spudger/marathon/schematics/README.md

# Schematics

Exports of the Marathon schematic, for viewing without KiCad.

**Status:** Phase 3, mostly complete, with ERC clean. The source is [`../pcb/marathon.kicad_sch`](../pcb/marathon.kicad_sch).

Will contain `marathon.pdf`, added once the sheet layout has been cleaned up for readability.
