spudger/marathon/case/renders/angle-back.png

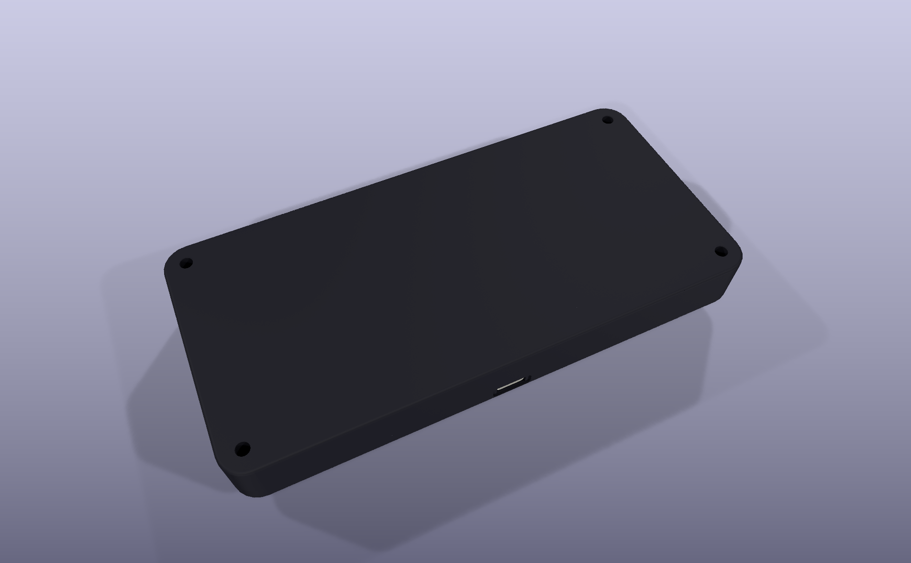
case/renders/angle-back.png
