spudger/marathon/case/renders/exploded.png

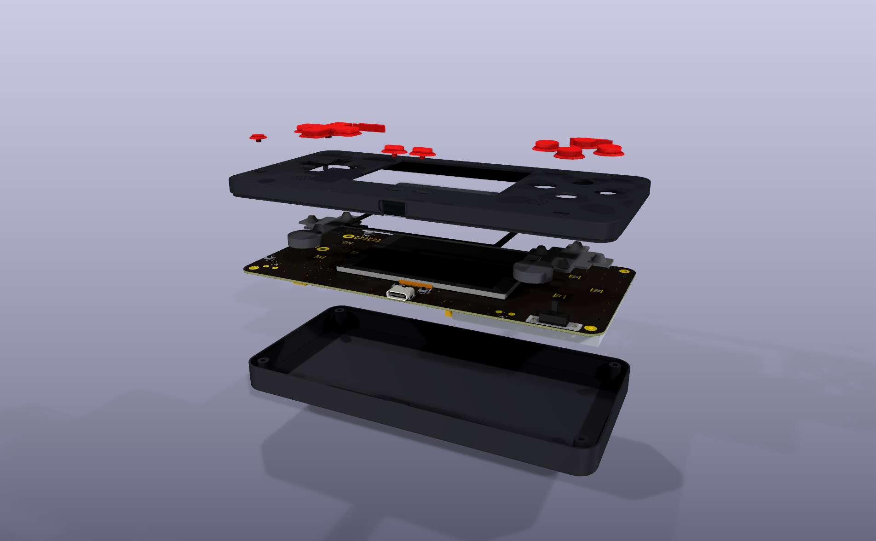
case/renders/exploded.png
