spudger/marathon/case/renders/section.png

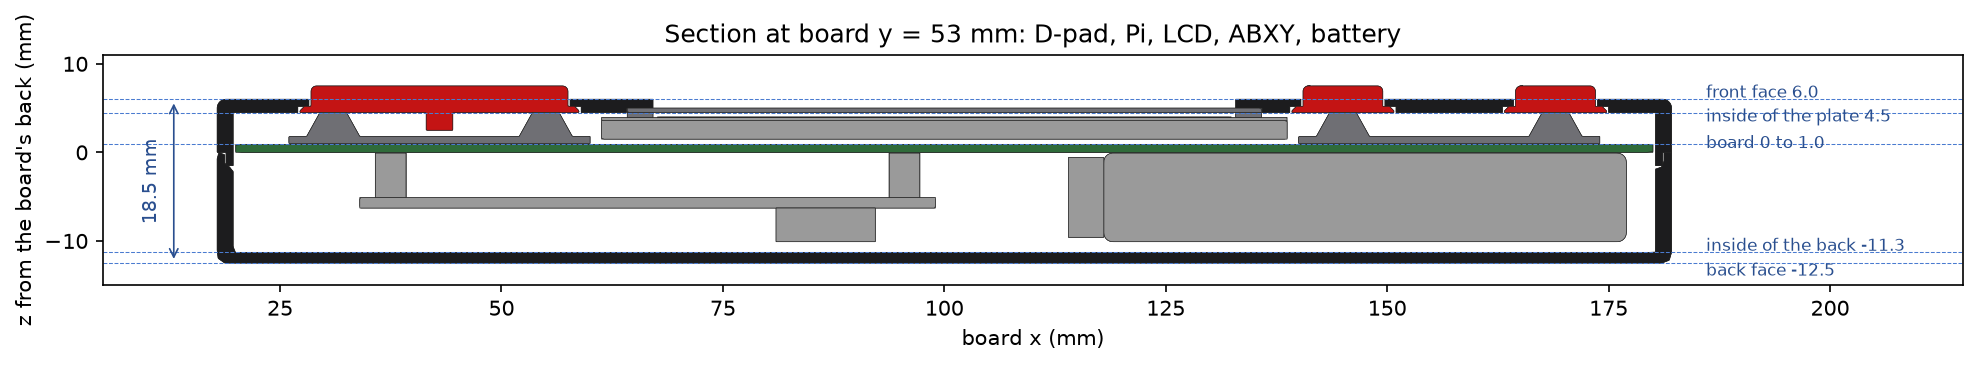
case/renders/section.png
