spudger/marathon/case/renders/social-preview.png

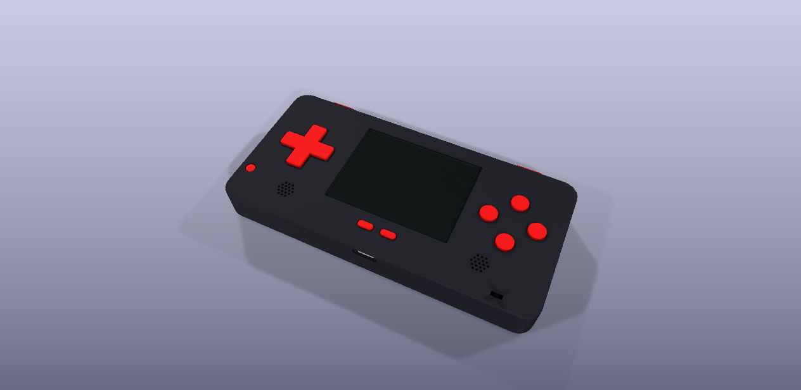
case/renders/social-preview.png
