spudger/marathon/pcb/renders/bottom.png

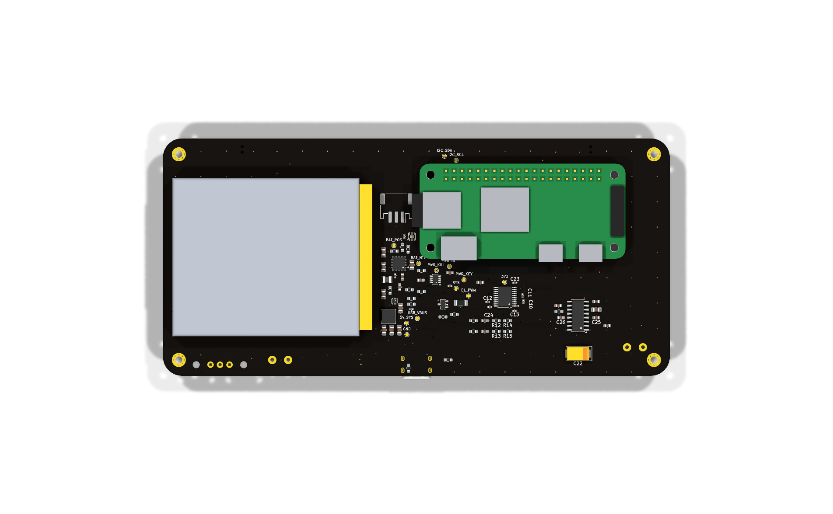
pcb/renders/bottom.png
