spudger/marathon/pcb/renders/top.png

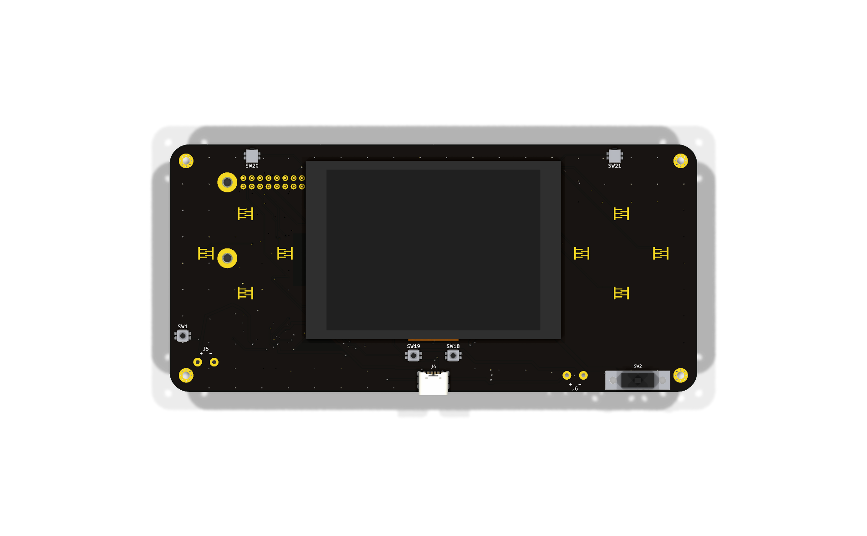
pcb/renders/top.png
