spudger/marathon/bom/README.md

# Marathon - Bill of Materials

Prototype work also uses a standard breadboard, jumper wires, and tactile push buttons for GPIO testing. These are commodity items and are not listed as line items below.

---

## 1. Compute

| Component | Spec | Est. Cost | Notes |
|---|---|---|---|
| Raspberry Pi Zero 2 W | ARM Cortex-A53, WiFi/BT | ~$15 | No-headers variant recommended for the final PCB. The Pi mounts on the back of the board on 5 mm M2.5 nylon standoffs, joined by a 2x20 strip of long-tail header pins soldered through both boards. The WH (with headers) is fine for breadboard prototyping, but its header would have to come off first. |

## 2. Power

| Component | Spec | Est. Cost | Notes |
|---|---|---|---|
| IP5306 breakout board (prototype) | 5V 2A boost + LiPo charger + load sharing | $10 (10-pack) | Outputs 5.1V. No USB port on this board variant; USB-C cable soldered directly to VIN/GND. Auto-shuts down with no load, auto-starts when Pi draws current. Play-while-charging confirmed. |
| Charger (final PCB) | TI BQ25616RTWR, WQFN-24 4 x 4 mm, LCSC C2866447 | ~$2 | Switching charger with power path. Resistor-set 0.9 A charge (0.96 A worst case), about 1.4 A input limit, 4.2 V charge voltage, charging only between 0 °C and 45 °C. Nothing about charging depends on software. |
| Boost (final PCB) | TI TPS61023DRLR, SOT-563, LCSC C919459 | <$0.50 | SYS to 5V_SYS at 5.06 V. Its enable pin is the power switch; the output is fully disconnected when off. |
| Power key controller (final PCB) | Analog Devices LTC2954CTS8-1, TSOT-23-8, LCSC C683782 | ~$6.70 | Hold the key about 1 s to turn on. A press of 0.5 to 6 s asks Linux to shut down (INT on GPIO7); Linux cuts power at the end through KILL on GPIO15. A hold of 6.8 to 14.5 s forces power off. |
| Fuel gauge (final PCB) | Analog Devices MAX17048G+T10, TDFN-8 2 x 2 mm, LCSC C2682616 | ~$1.50 | Battery percentage over I2C (0x36) on GPIO2/GPIO3. Powered from the cell. |
| LiPo Battery (prototype) | 3.7V 500mAh, 702540, JST-PH 2.0 | $7.09 | Soldered directly to IP5306 BAT/GND pads. Charges from wall USB charger (MacBook USB was unreliable for charging). |
| LiPo Battery (final) | 3.7V, about 4000 mAh, 105060 class, about 10 mm thick | ~$7-10 | The PCB reserves 67 x 59 mm on the back for a cell up to 57 x 65 mm with its protection board (`planning/specs/022-BATTERY-SPACE.md`). Provisional pick, until it passes the spec's arrival checks: Bihuade 105063, 4000 mAh, with the JST-PH 3-pin NTC option (about $9.90, https://bihuade.com/products/37v-105063-4000mah). Fallback: the Bihuade 105060, 3500 mAh, with the same option and 3 mm shorter, for about 3.6 hours of heavy play instead of 4.2. The cell must charge at 1.0 A or more, discharge 2 A continuously, have a protection board that trips above 3 A, charge to 4.2 V (not a 4.35 V cell), and carry a 10k B3435 NTC on a third wire. If its NTC is a different type, tape a Semitec 103AT-2 (DigiKey 4316-103AT-2-ND, $0.68) to the cell's edge and wire that instead. |
| USB-C connector (final PCB) | GCT USB4125-GF-A-0190, six-contact, power only, LCSC C5246813 | <$1 | 5.1k pulldowns on CC1 and CC2 so C-to-C chargers supply 5V. No USB data lines. |
| Battery connector (final PCB) | JST S3B-PH-SM4-TB(LF)(SN), PH 2.0 mm 3-pin right-angle SMT, LCSC C265101 | <$0.50 | Pin 1 BAT+, pin 2 NTC, pin 3 GND. JST-PH cells don't share one pin order, so check the chosen cell's drawing before ordering. With no NTC connected the charger reads cold and won't charge. B1 opens toward the board's top edge (spec 022); when the cell arrives, check that its mated plug and the bend in its wires fit in the free area above B1. |

**Why not the IP5306 on the final board**: it charges at a fixed 2.1 A, more than thin cells allow, has no battery temperature input, and can't power off after Linux halts. The prototype still uses the IP5306 breakout. The design is in [`planning/specs/011-POWER-DESIGN.md`](../planning/specs/011-POWER-DESIGN.md).

## 3. Display

| Component | Spec | Est. Cost | Notes |
|---|---|---|---|
| ILI9341 3.2" SPI LCD (prototype) | 240x320, SPI, 14-pin breakout module with header pins | $7.60 | 14-pin header (9 used + 5 touch pins unused). Driven by fbcp-ili9341 over SPI. VCC on 3.3V, not 5V. Display resolution slightly blurry (640x480 scaled to 320x240); fixable by tuning HDMI config. |
| ILI9341 3.2" SPI LCD (bare screen only) | 240x320, SPI, 18-pin FPC ribbon, no adapter board | ~$7 | For final PCB. FPC ribbon solders directly to pads on custom board. |

## 4. Audio

| Component | Spec | Est. Cost | Notes |
|---|---|---|---|
| PCM5102A DAC breakout (prototype) | I2S input, line-level output, 11-pin left + 3-pin right (R/G/L) | ~$2 | Config pins: FLT, DMP, FMT, SCL to GND; XMT to 5V (unmute). I2S via `dtoverlay=hifiberry-dac`. L/R audio outputs soldered directly to PAM8403. |
| PCM5102A IC (final PCB) | TI PCM5102APWR, TSSOP-20 (6.5 x 4.4 mm), LCSC C107671 | <$2 | Bare chip on the final PCB, all supplies on 3.3V. Eliminates the bulky breakout board. JLCPCB assembly. |
| PAM8403 amp breakout (prototype) | Class-D stereo, 3W per channel | ~$3.55 (5-pack) | Input pins labeled L/G/R (note: "R" may look like "B" on silkscreen). PCM5102A L/R outputs soldered directly to PAM8403 L/R inputs, G to G. POWER+ to 5V, POWER- to GND. |
| PAM8403 IC (final PCB) | Slkor PAM8403, SOP-16 (9.9 x 3.9 mm), LCSC C5122557 | <$1 | Bare chip on the final PCB. Slkor part used because the Diodes Inc. original is NRND/EOL. JLCPCB assembly. |
| Speakers (x2) | 8 ohm, 1W, 15mm, pre-wired | $2.87 | Both channels verified working in prototype. Connected to PAM8403 LOUT+/-, ROUT+/-. |
| Mute switch | SPDT slide switch (SS12F15-G5), through-hole | <$1 | Bottom-right edge of the PCB. Drives the PAM8403 SHDN/MUTE pins: 5V plays, GND mutes. The amp stays powered. Fine volume control handled via RetroPie software. |

**No headphone jack** - Bluetooth audio available via Pi Zero 2W's BT 4.2 for private listening. Speakers are the primary audio output. Note: BT audio has latency (~100-300ms), fine for passive games but not ideal for timing-sensitive gameplay.

**Audio chain**: Pi (I2S) → PCM5102A (DAC) → PAM8403 (amp) → Speakers. The mute switch holds the amp in shutdown.

## 5. Buttons / Input

| Component | Spec | Est. Cost | Notes |
|---|---|---|---|
| Silicone membrane pads (x2) | Cross/diamond-shaped, 4-way conductive rubber, identical pads for D-pad and ABXY | ~$3-5 | Two identical cross-shaped pads needed (one for D-pad, one for ABXY). Options: generic cross pads, GBC D-pad pads, SNES-style pads, or DS-style pads. Buy pads first, then design PCB contact pad spacing to match. Search AliExpress: "conductive silicone rubber button pad cross". See also: [ZedLabz GBC pads](https://www.zedlabz.com/products/conductive-silicone-rubber-button-membrane-contact-pads-for-nintendo-game-boy-color-cgb-gbc-zedlabz), [AliExpress conductive silicone buttons](https://www.aliexpress.com/w/wholesale-conductive-silicone-rubber-button.html). |
| SMD tactile switches (x3) | Alps Alpine SKTHACE010, 3.5 x 3.2 x 1.8 mm top-push | <$1 | Start, Select, and the power key. |
| Side-push SMD switches (x2) | Alps Alpine SKSCLDE010, 3.5 x 3.55 x 1.25 mm | <$1 | L and R shoulders, on the top edge of the PCB. |

**All gameplay buttons are direct GPIO** - no I2C expander needed. Each button shorts its GPIO to ground (active low) using the Pi's internal pull-up resistors. There is no dedicated system/hotkey button; Select takes that role in EmulationStation. The power key (SW1) connects to the LTC2954 power key controller, which tells the Pi to shut down through GPIO7.

**D-pad and ABXY contacts** are 5 mm interdigitated copper pads on the PCB itself (ENIG finish, no solder paste). The rubber pill on the membrane bridges the two combs when pressed.

## 6. Passive Components (Final PCB)

| Component | Spec | Est. Cost | Notes |
|---|---|---|---|
| R30 - Backlight resistor | 22 ohm, 0.5W, 1206 | <$0.10 | 5V to the backlight anode. About 86 mA through a 3.1V backlight. |
| Q1 - Backlight switch | AO3400A N-MOSFET, SOT-23, LCSC C20917; R41 100 ohm gate, R42 100k pull-down | <$0.10 | Backlight cathodes to GND, PWM from GPIO13. Off until the Pi drives the pin. |
| L1 - Boost inductor | 1 uH shielded, saturation current at least 4.5 A, low DCR, 4 x 4 mm molded (XAL4020 footprint) | <$1 | **Part number not chosen yet.** For the TPS61023. |
| L2 - Charger inductor | 1 uH, TDK TFM252012ALMA1R0MTAA, 2.5 x 2.0 x 1.2 mm, LCSC C404802 | <$1 | For the BQ25616. |
| Charger support | C1 1uF (VBUS), C27 10uF 10V 0603 (PMID), C28 10uF (SYS), C2 22uF (BAT), C29 4.7uF 10V (REGN), C30 47nF (BTST); R32 750R, R33 340R, R34 5.23k, R35 30.9k, all 1% | <$0.50 total | R32 sets the charge current, R33 the input limit, R34/R35 the 0 to 45 °C window. VSET, D+ and D- stay unconnected. |
| Boost support | C31 10uF (VIN), C3-C6 22uF (5V out, 0805); R36 750k and R37 100k, 1%; C32 220pF | <$0.30 total | R36/R37 set 5.06 V. C32 is the feedforward capacitor the datasheet asks for above 40 uF of output capacitance. |
| Power key support | C33 0.15uF and C34 1.5uF, X7R 10%; C35 0.1uF; R38 1M; R39/R40 10k | <$0.30 total | C33 sets the 1 s turn-on hold, C34 the forced-off hold. R38 pulls the boost enable to SYS; R39/R40 pull INT and KILL to 3V3. |
| Fuel gauge support | C36 0.1uF | <$0.05 | VDD bypass at the gauge. |
| PCM5102A support | C10/C11 2.2uF, C12/C13/C23/C24 0.1uF (0402), C14 10uF (0603) | <$0.30 total | Charge pump, VNEG, LDO, and one bypass capacitor at each supply pin. Config pins are strapped directly, no resistors. |
| DAC output filter | R10/R11 470 ohm, C15/C16 2.2nF, R12/R13 8.2k, R14/R15 470 ohm, C17/C18 0.47uF, 0603 | <$0.30 total | Low-pass at about 154 kHz, a 25.3 dB attenuator (about 2.4 V peak per speaker at full scale with the amp's nominal 24 dB gain: 0.35 W sine, 0.70 W square wave), then AC coupling into the amp. |
| PAM8403 support | R20 100k, C20 1uF (VREF), C21/C25/C26 1uF, C22 220uF 10V polymer (Panasonic 10TPE220ML, 7343, 2.8 mm tall, LCSC C147767) | <$1 total | R20 holds MUTE/SHDN low while SW2 moves. C21, C25 and C26 bypass each supply pin. C22 is bulk supply for the amp, low enough to sit beside the battery. |
| USB-C CC resistors (x2) | R1/R2 5.1k ohm, 0603 | <$0.10 | Required for USB-C spec compliance. |

LCSC part numbers for the passives are not chosen yet. Values come from the schematic in [`pcb/marathon.kicad_sch`](../pcb/marathon.kicad_sch).

## 7. Mechanical / Case

| Component | Spec | Est. Cost | Notes |
|---|---|---|---|
| 3D printed case | Two shells and printed caps, PETG or PLA | ~$3 filament | First concept: STLs and print notes in [`case/`](../case/), design in `planning/specs/027-CASE-CONCEPT.md`. Not printed yet. |
| M2 screws (x4) | M2 x 12 mm socket head, DIN 912 | <$2 | From the back, through the board's case holes, into the inserts. |
| M2 heat-set inserts (x4) | M2 x 3 mm, 3.2 mm hole | <$2 | Pressed into the front shell's bosses. |
| Screen lens | 0.5 mm clear acrylic or polycarbonate, 71.6 x 55.4 mm | ~$2 | Laser-cut. Sits in a pocket inside the front shell. |
| Foam and tape | 1 mm closed-cell foam tape; thin double-sided tape; Kapton tape | ~$3 | Foam gasket between the lens and the LCD, about twice the gap; tape holds the lens; Kapton covers the Pi header's trimmed pins under the LCD. |
| Micro SD card | 32GB+ Class 10 | ~$8 | For RetroPie image. |

---

## Estimated Cost Summary

### Prototype Order (2026-03-22)

| Item | Source | Cost |
|---|---|---|
| IP5306 breakout (10-pack) | Amazon | $10.00 |
| LiPo battery 500mAh | Amazon | $7.09 |
| PCM5102A DAC breakout (x2) | AliExpress | ~$2.00 |
| PAM8403 amp breakout (5-pack) | AliExpress | ~$3.55 |
| ILI9341 3.2" SPI display | AliExpress | $7.60 |
| Speakers 15mm (pair) | AliExpress | $2.87 |
| **Prototype total** | | **~$33** |

Amazon order: ~$17 | AliExpress order: ~$19 (may be split across multiple carts due to AE's Dollar Express vs regular marketplace).

### Final Build (Future, estimates only)

| Category | Est. Cost |
|---|---|
| Display (bare screen for PCB) | ~$7 |
| Battery (about 4000 mAh) | ~$7-10 |
| Buttons / input (silicone pads, tactile switches) | $5-7 |
| Case / mechanical | TBD |
| PCB fabrication (JLCPCB) | ~$5-15 |
| PCB assembly (JLCPCB) | ~$10-20 |
| Passive components | <$3 |
| **Final build estimate** | **~$35-60** |

---

## Sourcing

| Supplier | What to buy there |
|---|---|
| **Amazon** | IP5306 breakout boards, LiPo battery (prototype) |
| **AliExpress** | PCM5102A, PAM8403, ILI9341 display, speakers. Future: buttons, silicone pads, final battery |
| **JLCPCB/PCBWay** | PCB fabrication + SMT assembly for final board |
| **In-house** | 3D-printed case, from the STLs in `case/`. |

---

## Decision Log

| Date | Decision | Rationale |
|---|---|---|
| 2026-03-03 | IP5306 for power management | Handles charging + boost + load sharing in one chip. Cheap breakout boards available for prototyping. Same chip integrates onto final PCB. |
| 2026-03-03 | Prototype with breadboard + IP5306 boards | Tactile learning experience, no bench supply needed, cheap to iterate. |
| 2026-03-03 | JLCPCB/PCBWay for final assembly | They can solder SMD components (IP5306, passives) onto the custom PCB. |
| 2026-03-03 | Integrate ALL breakout boards as bare chips on final PCB | By integrating IP5306 + PAM8403 + PCM5102A as bare ICs directly on the PCB instead of using breakout boards, we reclaim ~15-20cm² of space for a larger battery. Prototype with breakout boards, final build uses integrated chips. |
| 2026-03-03 | Battery: maximize area, keep thin (≤6mm) | No extra width available in case. Instead of going thicker, reclaim board space and use a wider/longer thin cell. Minimum target 2000mAh, stretch 3000mAh. Final size TBD after PCB layout. |
| 2026-03-03 | Ditch headphone jack, keep speakers + mute switch | No 3.5mm devices owned. Bluetooth available via Pi Zero 2W for private listening (with latency tradeoff). Speakers for gameplay audio. Mute switch for quick silence. Software volume via RetroPie for fine control. Saves board space and simplifies audio circuit. |
| 2026-03-05 | ILI9341 display: bare 18-pin FPC screen + adapter board | Same listing for both prototype and final build. Adapter board breaks 18-pin FPC to 14-pin header for breadboard use (with F-M jumper wires). Bare screen ribbon solders to final PCB. [AliExpress](https://www.aliexpress.com/item/1005003005329598.html). Buy 1x with adapter + 1x bare. ~$7 each. |
| 2026-03-05 | Speakers: 8 ohm, 1W, ~10-15mm pre-wired | Commodity part, not mission-critical. Any 8 ohm small speaker works with PAM8403. Exact size to be matched to case cutouts later. ~$2 for a pair. |
| 2026-03-05 | Silicone membrane pads for D-pad + ABXY | Two identical cross-shaped pads for D-pad and ABXY. Plan: buy pads first, design PCB contact spacing to match. Still researching exact source. Options include generic cross pads or repurposed console pads (GBC, SNES, DS). |
| 2026-03-22 | Prototype order placed (Amazon + AliExpress) | All prototype components ordered. Amazon: IP5306 boards (10-pack) + 500mAh LiPo. AliExpress: PCM5102A (x2), PAM8403 (5-pack), ILI9341 3.2" display, speakers. Total ~$36. |
| 2026-03-22 | Prototype display: all-in-one module (not bare FPC + adapter) | Found an ILI9341 3.2" SPI module with screen and pins on a single rigid board that plugs directly into a breadboard. Easier for prototyping than the bare FPC + adapter approach. Bare FPC screen still planned for final PCB. |
| 2026-04-03 | Breadboard prototype: all subsystems verified | Power (IP5306, 5.1V output, play-while-charging), display (ILI9341 via SPI/fbcp-ili9341), audio (PCM5102A DAC + PAM8403 amp, I2S via hifiberry-dac overlay), buttons (mk_arcade_joystick_rpi kernel module). Full prototype build guide in documentation/PROTOTYPE_BUILD_GUIDE.md. |
| 2026-04-04 | Button driver: mk_arcade_joystick_rpi, NOT retrogame | Retrogame creates a virtual keyboard device that EmulationStation (on this Buster image) does not recognize. mk_arcade_joystick_rpi creates a proper joystick device that ES natively supports. Config: map=5 with custom GPIO list. |
| 2026-04-21 | Pi Zero 2 W (no headers) for final build | Final PCB solders the Pi direct. WH variant is fine for prototyping but headers have to be desoldered before the final build. Plain W is cheaper and saves the desolder step for anyone replicating this. |
| 2026-04-21 | Case: custom 3D-printed design | Earlier plan was to base the case on existing Thingiverse STLs. Decision changed to designing the case from scratch to fit the custom PCB footprint, battery, and component layout exactly. STL files will be published in this repo when the design is complete. |
| 2026-09-21 | Locked final-PCB parts | IP5306 (LCSC C181692), PCM5102APWR (C107671), Slkor PAM8403 (C5122557) because the Diodes Inc. part is NRND/EOL, GCT USB4125 power-only USB-C (C5246813), JST-PH battery connector (C295747), Alps SKTHACE010 / SKSCLDE010 switches. |
| 2026-09-21 | Backlight from 5V through 22 ohm | The bare panel has no current limiting. 3.3V leaves only 0.2V of headroom over the ~3.1V backlight, so the current would swing with LED tolerance. 5V through 22 ohm gives about 86 mA. |
| 2026-09-21 | Landscape layout, 160 x 75 mm | Screen centered, D-pad left, ABXY right, shoulders on the top edge. The 77.4 x 54 mm LCD body sets the minimum size. |
| 2026-09-22 | Pi mounts on standoffs with long-tail header pins | Pi on the back of the board, component side out, 5 mm M2.5 standoffs, 2x20 long-tail pins soldered through both boards. Replaces the earlier plan of soldering the Pi flat to pads. |
| 2026-09-22 | 1.0 mm board, ENIG finish | Thin handheld target. ENIG because the membrane buttons press directly on exposed copper contacts. |
| 2026-11-02 | Replace the IP5306 with a BQ25616 charger, TPS61023 boost, LTC2954 power key controller and MAX17048 gauge | Thin cells allow about 1 A of charge, not the IP5306's fixed 2.1 A, and charging needs a temperature cutoff. The power key now shuts Linux down cleanly, the board powers off after a halt, and the Pi can read the battery level. Battery space grows to 63 x 50 mm for a 505060 cell with its protection board. Spec: `planning/specs/011-POWER-DESIGN.md`. |
| 2026-11-07 | Battery space grows to 67 x 59 mm, for a 105060-class cell of about 4000 mAh, about 10 mm thick | No in-stock cell that fit 63 x 50 x 6 mm held more than about 2000 mAh, about 2 hours of heavy play. The case gets about 1.3 mm deeper than the Pi needs. B1 turns to open toward the top edge, clear of the cell. Spec: `planning/specs/022-BATTERY-SPACE.md`. |
| 2026-11-08 | Case: first concept in CadQuery, two shells held by M2 screws into heat-set inserts | The case is code, so each change reads as a diff; the STEP file still opens in FreeCAD. The case prints at home without supports, black with red caps. Spec: `planning/specs/027-CASE-CONCEPT.md`. |
| 2026-11-08 | Case slimmed from 20.4 to 18.5 mm: header pins trimmed under the LCD, a 0.5 mm lens, a 1.2 mm floor, M2 x 12 mm screws | Thinner without shaping the back or shrinking the battery space. The 20.4 mm design is tagged `case-concept-1`. Spec 027, "Slimming". |
