spudger/marathon/case/step/marathon-case.step

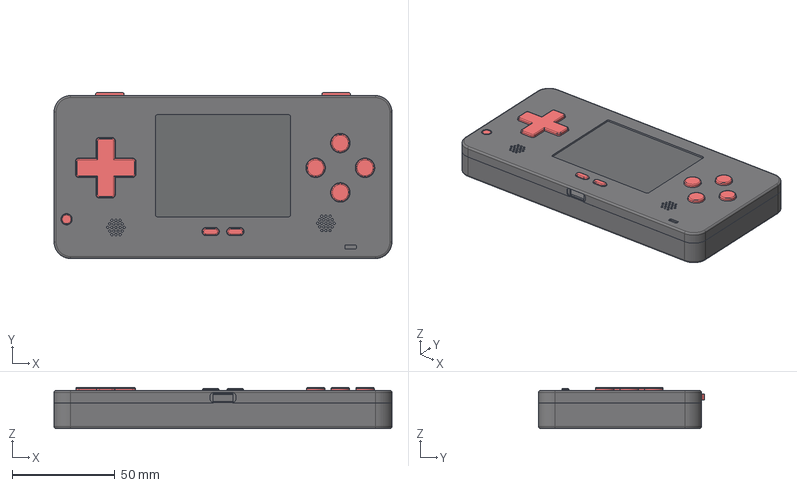
[picture p10: CAD file, 2026-11-10]
case/step/marathon-case.step
164.2 x 80.7 x 20.0 mm
front-shell_part
back-shell_part
cap-dpad_part
cap-abxy_part
cap-start_part
cap-select_part
cap-power_part
shoulder-l_part
shoulder-r_part
pad-dpad_part
pad-abxy_part
speaker-l_part
speaker-r_part
lens_part
gasket_part
