spudger/marathon/case/stl/cap-start-select.stl

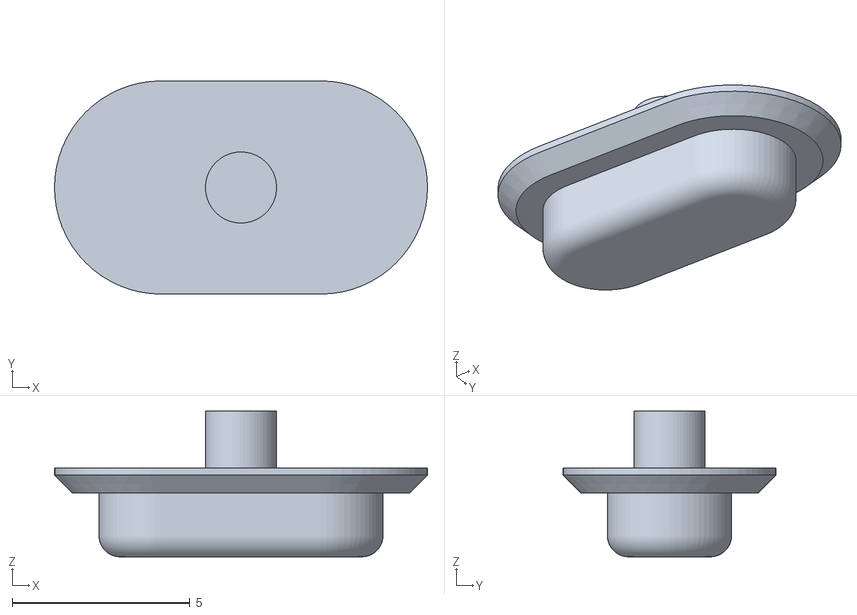
[picture p11: CAD file, 2026-11-10]
case/stl/cap-start-select.stl
10.5 x 6.00 x 4.10
