spudger/marathon/case/stl/cap-abxy.stl

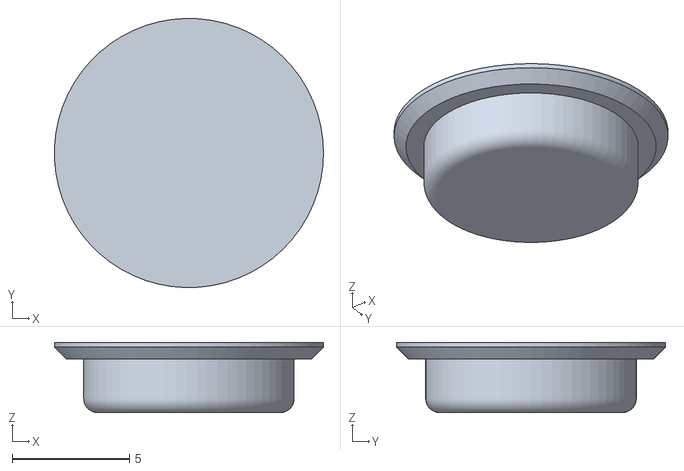
[picture p12: CAD file, 2026-11-10]
case/stl/cap-abxy.stl
11.5 x 11.5 x 3.00
