spudger/marathon/case/stl/cap-power.stl

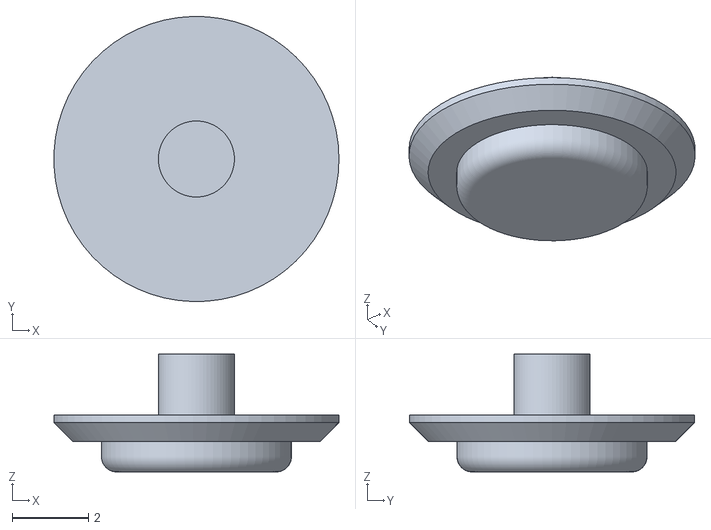
[picture p13: CAD file, 2026-11-10]
case/stl/cap-power.stl
7.50 x 7.50 x 3.10
