spudger/marathon/case/stl/front-shell.stl

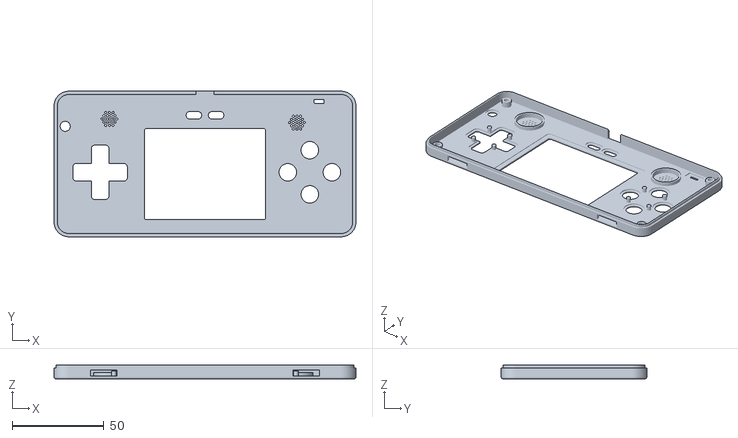
[picture p14: CAD file, 2026-11-10]
case/stl/front-shell.stl
164.2 x 79.2 x 7.50
