spudger/marathon/case/stl/shoulder.stl

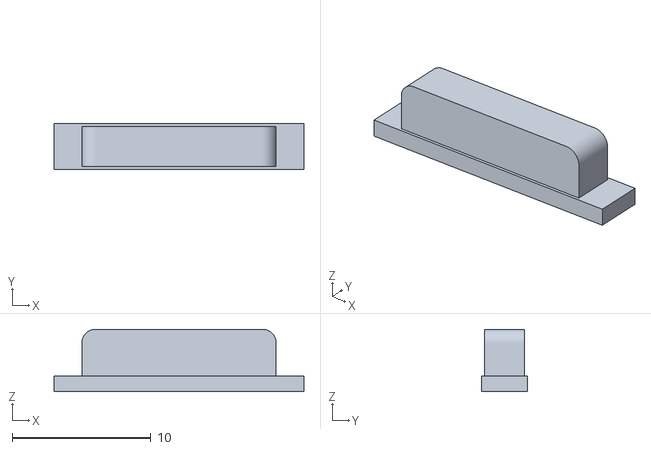
[picture p15: CAD file, 2026-11-10]
case/stl/shoulder.stl
18.0 x 3.30 x 4.50
