spudger/marathon/case/stl/back-shell.stl

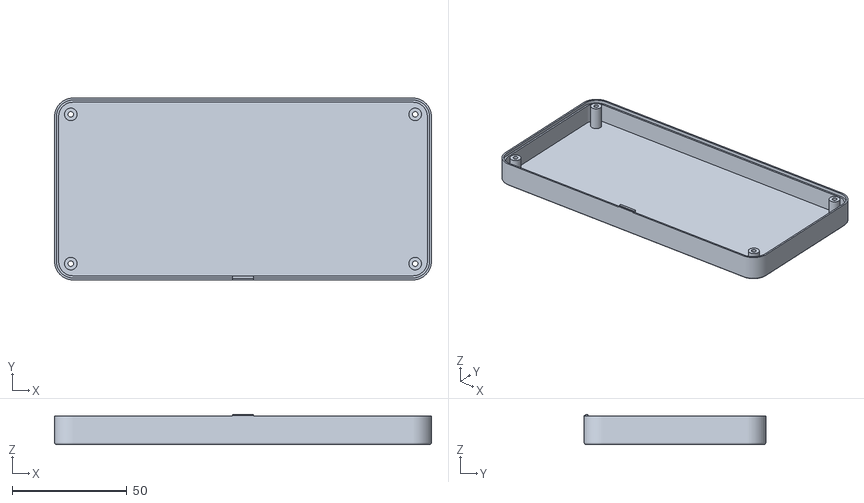
[picture p16: CAD file, 2026-11-10]
case/stl/back-shell.stl
164.2 x 79.2 x 13.2
