spudger/marathon/case/stl/cap-dpad.stl

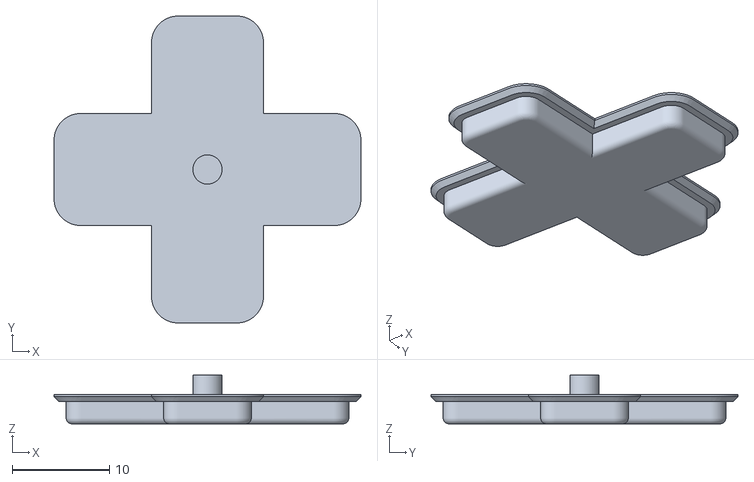
[picture p17: CAD file, 2026-11-10]
case/stl/cap-dpad.stl
31.5 x 31.5 x 5.00
