spudger/marathon/pcb/marathon.kicad_pcb

## KiCad design pcb/marathon.kicad_pcb (2026-11-08)

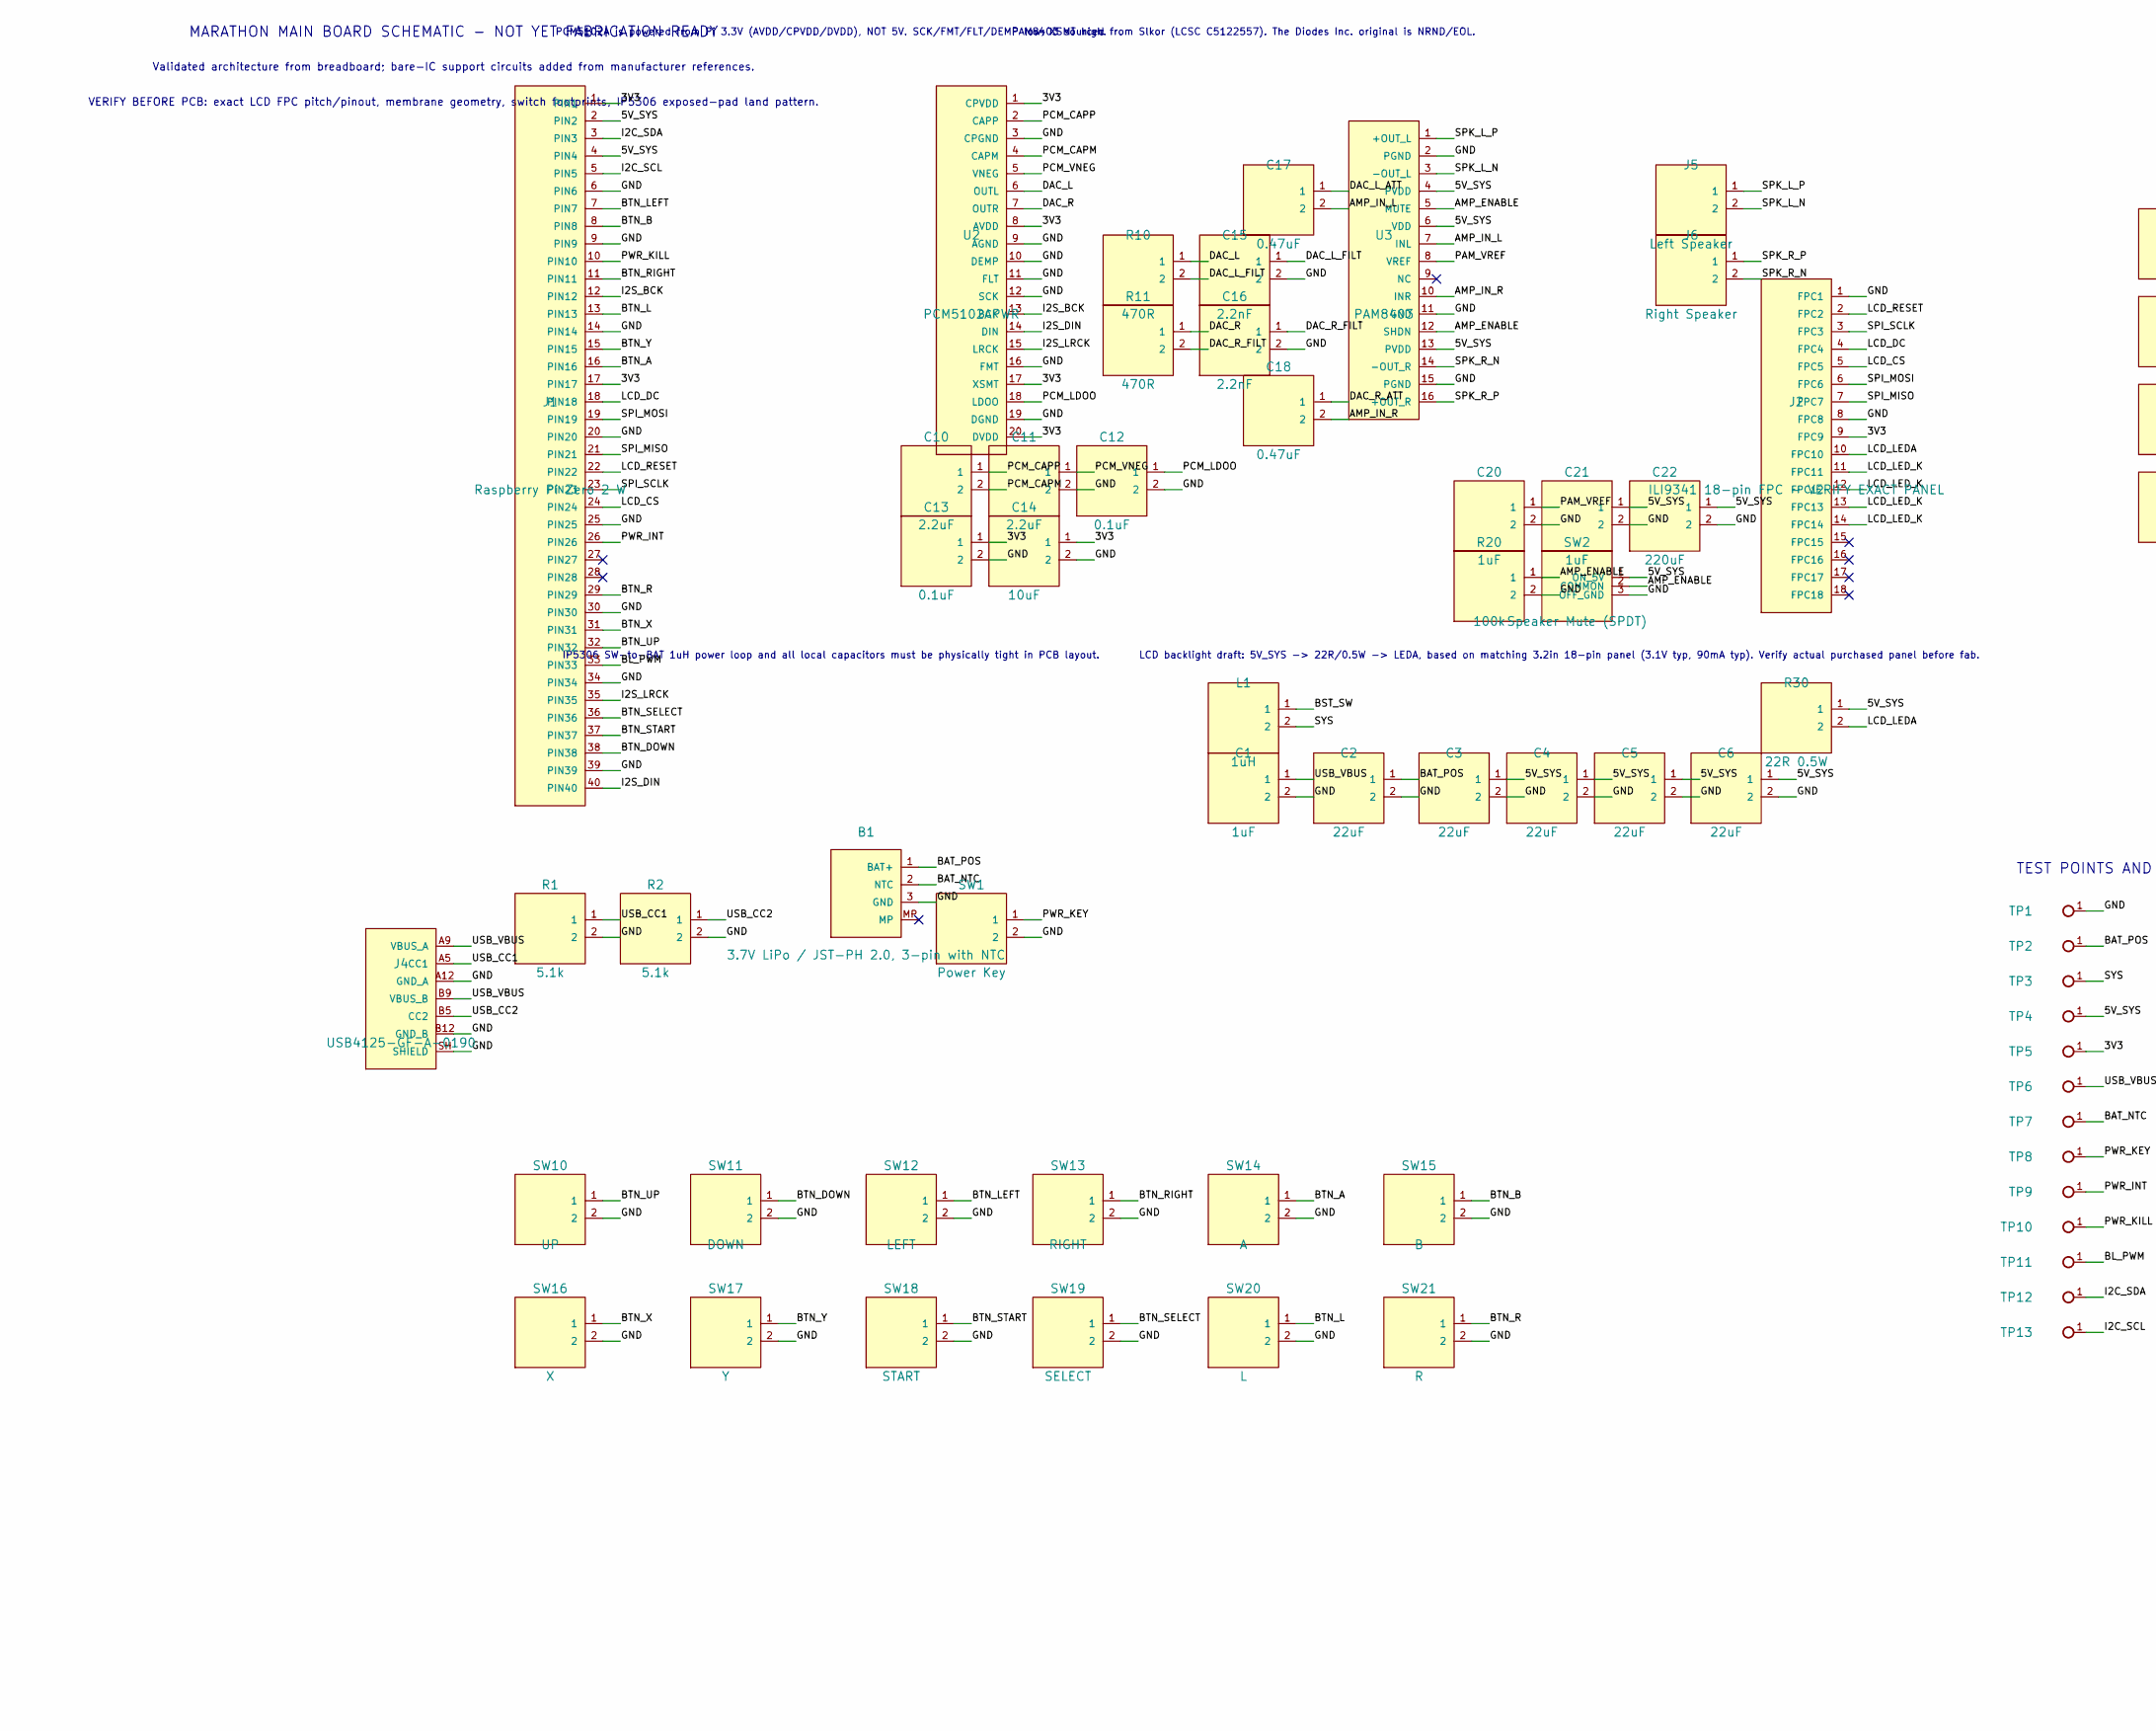
[picture p18: schematic marathon.kicad_sch, Marathon Handheld - Main Board, part in row 1, column 1]

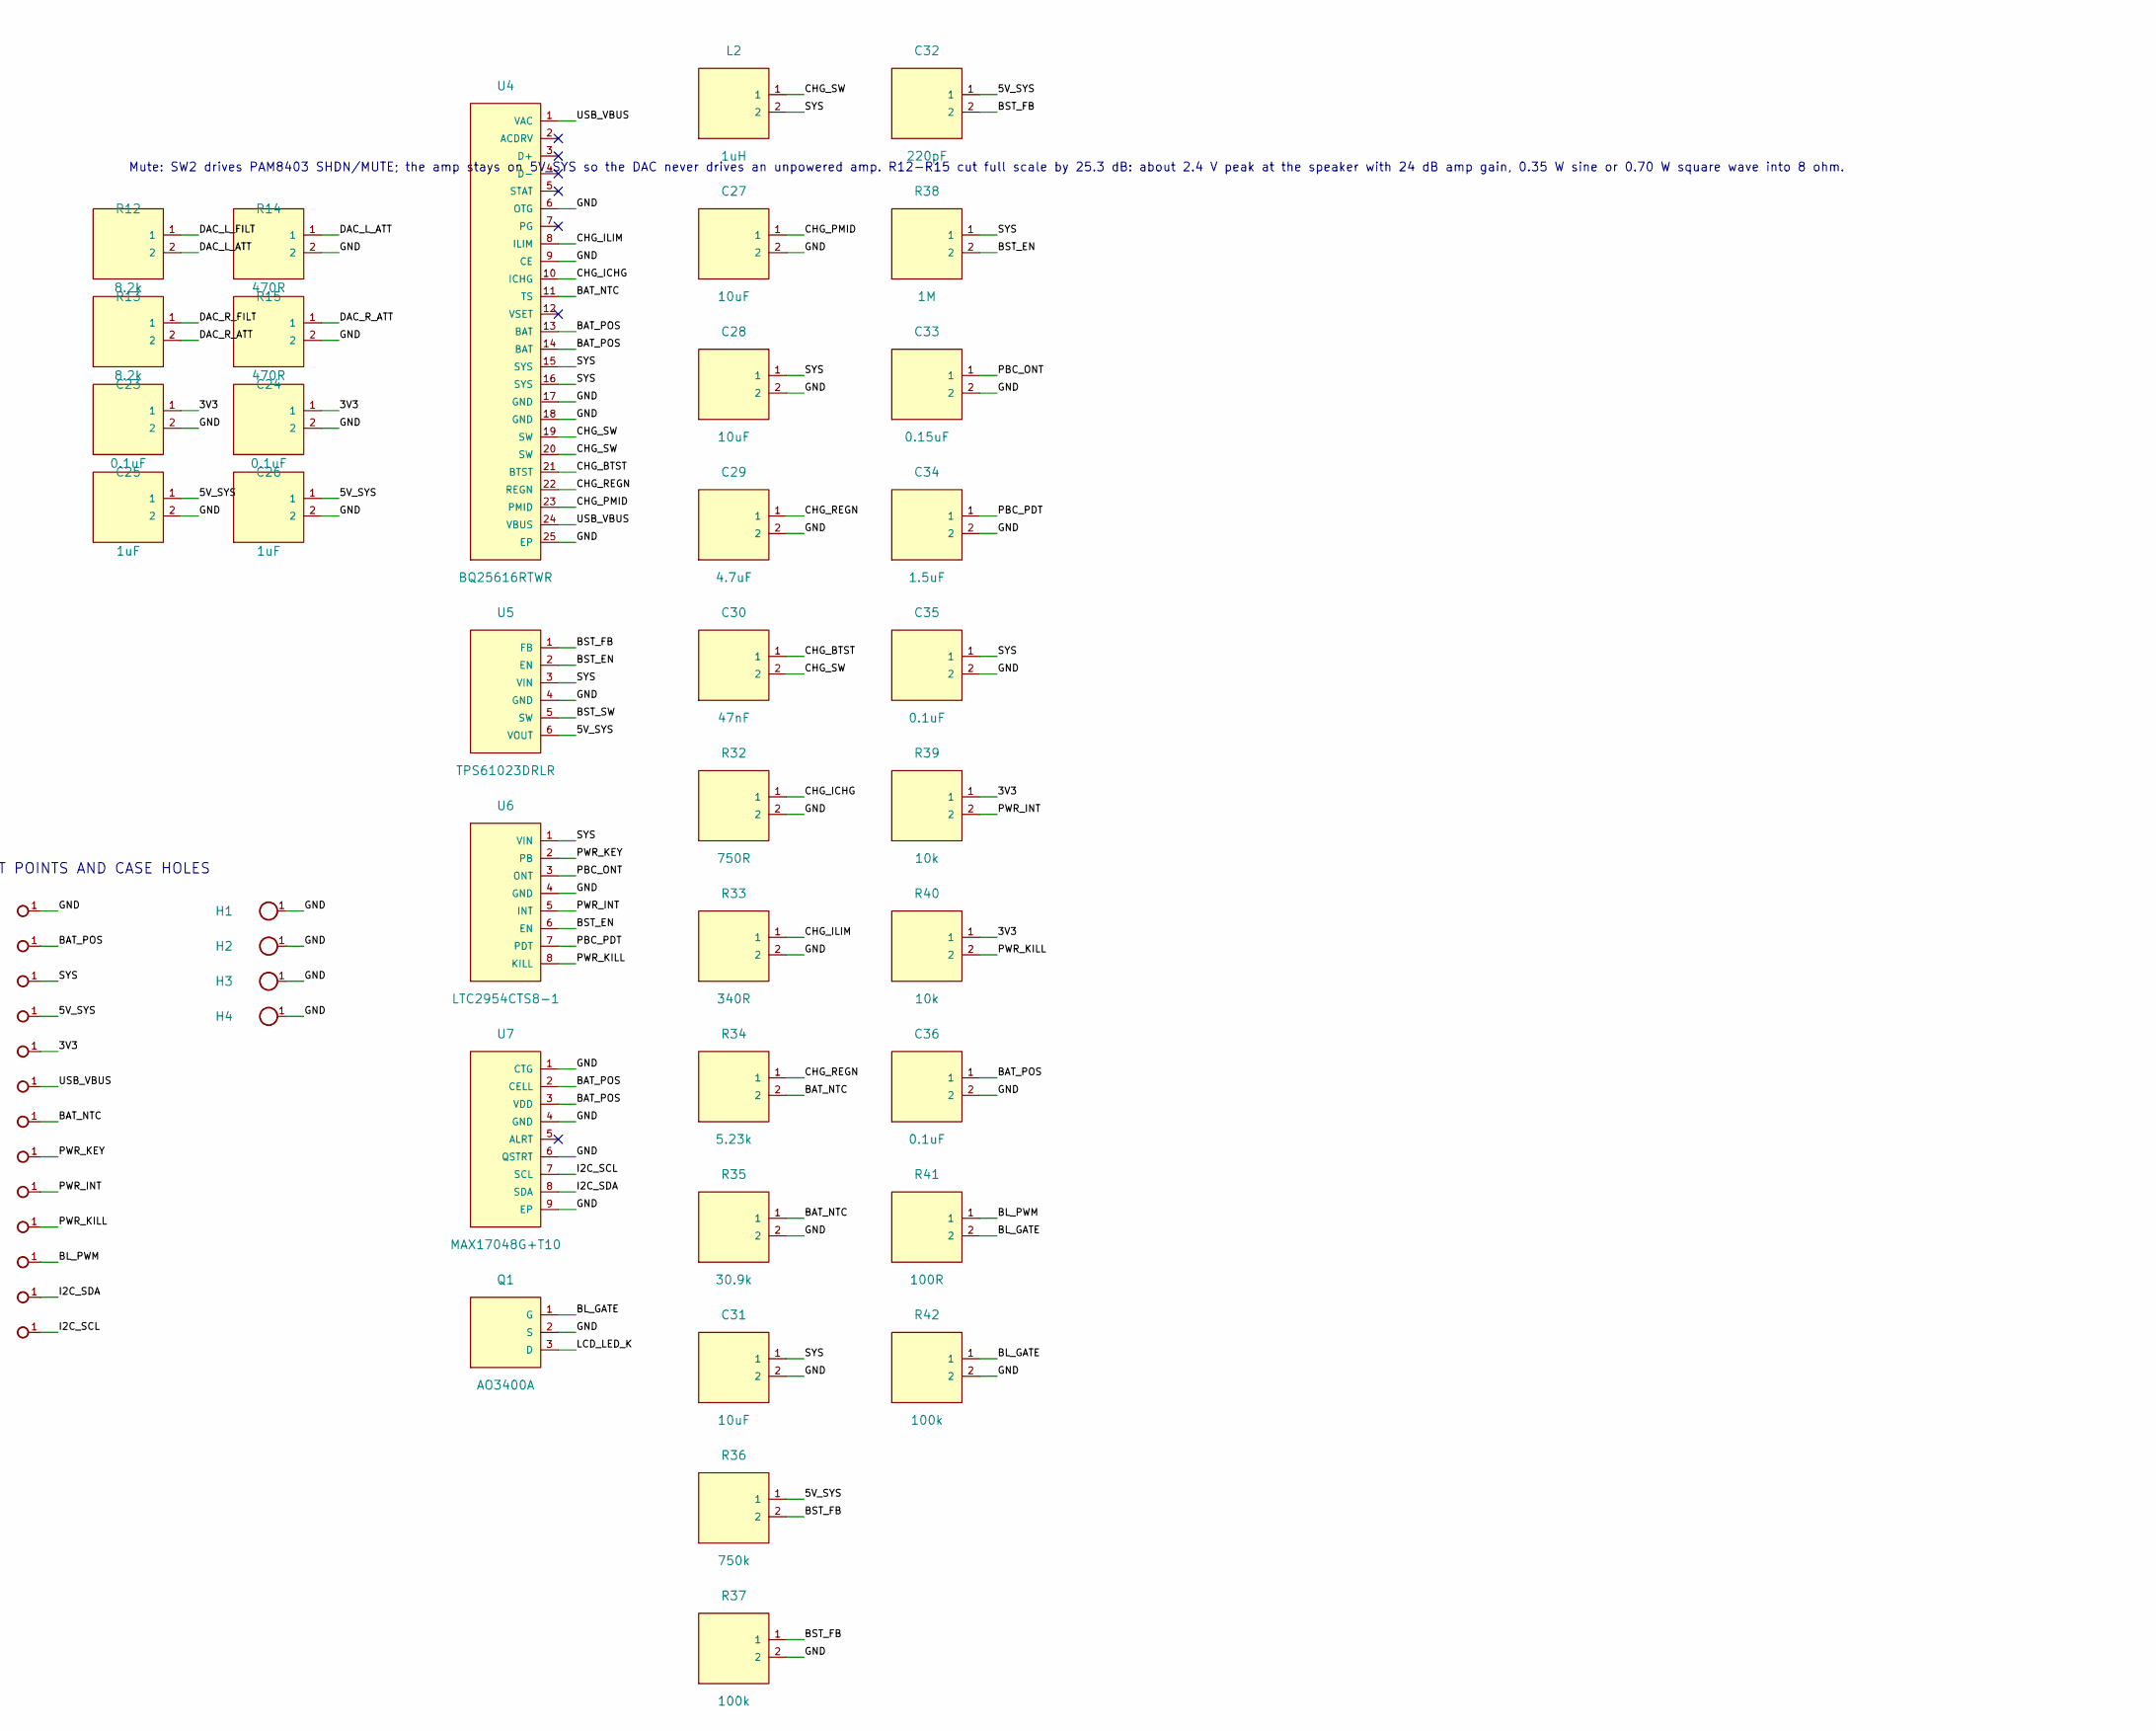
[picture p19: schematic marathon.kicad_sch, Marathon Handheld - Main Board, part in row 1, column 2]

Parts:
B1: 3.7V LiPo / JST-PH 2.0, 3-pin with NTC; JST_PH_S3B-PH-SM4-TB_1x03-1MP_P2.00mm_Horizontal
C1, C21: 1uF; C_0805_2012Metric_Pad1.18x1.45mm_HandSolder
C2, C3, C4, C5, C6: 22uF; C_0805_2012Metric_Pad1.18x1.45mm_HandSolder
C10, C11: 2.2uF; C_0402_1005Metric
C12, C13, C23, C24, C35, C36: 0.1uF; C_0402_1005Metric
C14, C27: 10uF; C_0603_1608Metric
C15, C16: 2.2nF; C_0603_1608Metric
C17, C18: 0.47uF; C_0603_1608Metric
C20, C25, C26: 1uF; C_0603_1608Metric
C22: 220uF; CP_EIA-7343-31_Kemet-D; MPN Panasonic 10TPE220ML; LCSC C147767
C28, C31: 10uF; C_0805_2012Metric_Pad1.18x1.45mm_HandSolder
C29: 4.7uF; C_0603_1608Metric
C30: 47nF; C_0402_1005Metric
C32: 220pF; C_0402_1005Metric
C33: 0.15uF; C_0603_1608Metric; Tolerance 10%
C34: 1.5uF; C_0603_1608Metric; Tolerance 10%
H1, H2, H3, H4: MountingHole_M2; MountingHole_2.2mm_M2_Pad_Via
J1: Raspberry Pi Zero 2 W; Raspberry_Pi_Zero_2W_DirectStack_THT
J2: ILI9341 18-pin FPC - VERIFY EXACT PANEL; LCD_FPC18_P0.8_DirectSolder_PROVISIONAL
J4: USB4125-GF-A-0190; USB_C_Receptacle_GCT_USB4125-xx-x-0190_6P_TopMnt_Horizontal; MPN USB4125-GF-A-0190; LCSC C5246813
J5: Left Speaker; Speaker_WirePads_2P_P5.0
J6: Right Speaker; Speaker_WirePads_2P_P5.0
L1: 1uH; L_Coilcraft_XAL4020-XXX
L2: 1uH; L_1008_2520Metric; MPN TDK TFM252012ALMA1R0MTAA; LCSC C404802
Q1: AO3400A; SOT-23; MPN AO3400A; LCSC C20917
R1, R2: 5.1k; R_0603_1608Metric_Pad0.98x0.95mm_HandSolder
R10, R11, R14, R15: 470R; R_0603_1608Metric_Pad0.98x0.95mm_HandSolder
R12, R13: 8.2k; R_0603_1608Metric_Pad0.98x0.95mm_HandSolder
R20, R42: 100k; R_0603_1608Metric_Pad0.98x0.95mm_HandSolder
R30: 22R 0.5W; R_1206_3216Metric_Pad1.30x1.75mm_HandSolder
R32: 750R; R_0603_1608Metric_Pad0.98x0.95mm_HandSolder; Tolerance 1%
R33: 340R; R_0603_1608Metric_Pad0.98x0.95mm_HandSolder; Tolerance 1%
R34: 5.23k; R_0603_1608Metric_Pad0.98x0.95mm_HandSolder; Tolerance 1%
R35: 30.9k; R_0603_1608Metric_Pad0.98x0.95mm_HandSolder; Tolerance 1%
R36: 750k; R_0603_1608Metric_Pad0.98x0.95mm_HandSolder; Tolerance 1%
R37: 100k; R_0603_1608Metric_Pad0.98x0.95mm_HandSolder; Tolerance 1%
R38: 1M; R_0603_1608Metric_Pad0.98x0.95mm_HandSolder
R39, R40: 10k; R_0603_1608Metric_Pad0.98x0.95mm_HandSolder
R41: 100R; R_0603_1608Metric_Pad0.98x0.95mm_HandSolder
SW1: Power Key; SW_Alps_SKTHACE010_PROVISIONAL; MPN SKTHACE010
SW2: Speaker Mute (SPDT); SS12F15_G5_THT
SW10: UP; Conductive_Pad_5mm_GameBoyStyle
SW11: DOWN; Conductive_Pad_5mm_GameBoyStyle
SW12: LEFT; Conductive_Pad_5mm_GameBoyStyle
SW13: RIGHT; Conductive_Pad_5mm_GameBoyStyle
SW14: A; Conductive_Pad_5mm_GameBoyStyle
SW15: B; Conductive_Pad_5mm_GameBoyStyle
SW16: X; Conductive_Pad_5mm_GameBoyStyle
SW17: Y; Conductive_Pad_5mm_GameBoyStyle
SW18: START; SW_Alps_SKTHACE010_PROVISIONAL; MPN SKTHACE010
SW19: SELECT; SW_Alps_SKTHACE010_PROVISIONAL; MPN SKTHACE010
SW20: L; SW_Alps_SKSCLDE010_PROVISIONAL; MPN SKSCLDE010
SW21: R; SW_Alps_SKSCLDE010_PROVISIONAL; MPN SKSCLDE010
TP1: GND; TestPoint_Pad_D1.0mm
TP2: BAT_POS; TestPoint_Pad_D1.0mm
TP3: SYS; TestPoint_Pad_D1.0mm
TP4: 5V_SYS; TestPoint_Pad_D1.0mm
TP5: 3V3; TestPoint_Pad_D1.0mm
TP6: USB_VBUS; TestPoint_Pad_D1.0mm
TP7: BAT_NTC; TestPoint_Pad_D1.0mm
TP8: PWR_KEY; TestPoint_Pad_D1.0mm
TP9: PWR_INT; TestPoint_Pad_D1.0mm
TP10: PWR_KILL; TestPoint_Pad_D1.0mm
TP11: BL_PWM; TestPoint_Pad_D1.0mm
TP12: I2C_SDA; TestPoint_Pad_D1.0mm
TP13: I2C_SCL; TestPoint_Pad_D1.0mm
U2: PCM5102APWR; TSSOP-20_4.4x6.5mm_P0.65mm; MPN PCM5102APWR; LCSC C107671
U3: PAM8403; SOIC-16_3.9x9.9mm_P1.27mm; MPN PAM8403 (Slkor); LCSC C5122557
U4: BQ25616RTWR; Texas_RTW_WQFN-24-1EP_4x4mm_P0.5mm_EP2.7x2.7mm_Vias0.3; MPN BQ25616RTWR; LCSC C2866447
U5: TPS61023DRLR; SOT-563; MPN TPS61023DRLR; LCSC C919459
U6: LTC2954CTS8-1; TSOT-23-8; MPN LTC2954CTS8-1#TRPBF; LCSC C683782
U7: MAX17048G+T10; TDFN-8-1EP_2x2mm_P0.5mm_EP0.8x1.2mm; MPN MAX17048G+T10; LCSC C2682616

Connections:
/3V3: C13.1, C14.1, C23.1, C24.1, J1.1 (PIN1), J1.17 (PIN17), J2.9 (FPC9), R39.1, R40.1, TP5.1, U2.1 (CPVDD), U2.8 (AVDD), U2.17 (XSMT), U2.20 (DVDD)
/5V_SYS: C3.1, C4.1, C5.1, C6.1, C21.1, C22.1, C25.1, C26.1, C32.1, J1.2 (PIN2), J1.4 (PIN4), R30.1, R36.1, SW2.1 (ON_5V), TP4.1, U3.4 (PVDD), U3.6 (VDD), U3.13 (PVDD), U5.6 (VOUT)
/AMP_ENABLE: R20.1, SW2.2 (COMMON), U3.5 (MUTE), U3.12 (SHDN)
/AMP_IN_L: C17.2, U3.7 (INL)
/AMP_IN_R: C18.2, U3.10 (INR)
/BAT_NTC: B1.2 (NTC), R34.2, R35.1, TP7.1, U4.11 (TS)
/BAT_POS: B1.1 (BAT+), C2.1, C36.1, TP2.1, U4.13 (BAT), U4.14 (BAT), U7.2 (CELL), U7.3 (VDD)
/BL_GATE: Q1.1 (G), R41.2, R42.1
/BL_PWM: J1.33 (PIN33), R41.1, TP11.1
/BST_EN: R38.2, U5.2 (EN), U6.6 (EN)
/BST_FB: C32.2, R36.2, R37.1, U5.1 (FB)
/BST_SW: L1.1, U5.5 (SW)
/BTN_A: J1.16 (PIN16), SW14.1
/BTN_B: J1.8 (PIN8), SW15.1
/BTN_DOWN: J1.38 (PIN38), SW11.1
/BTN_L: J1.13 (PIN13), SW20.1
/BTN_LEFT: J1.7 (PIN7), SW12.1
/BTN_R: J1.29 (PIN29), SW21.1
/BTN_RIGHT: J1.11 (PIN11), SW13.1
/BTN_SELECT: J1.36 (PIN36), SW19.1
/BTN_START: J1.37 (PIN37), SW18.1
/BTN_UP: J1.32 (PIN32), SW10.1
/BTN_X: J1.31 (PIN31), SW16.1
/BTN_Y: J1.15 (PIN15), SW17.1
/CHG_BTST: C30.1, U4.21 (BTST)
/CHG_ICHG: R32.1, U4.10 (ICHG)
/CHG_ILIM: R33.1, U4.8 (ILIM)
/CHG_PMID: C27.1, U4.23 (PMID)
/CHG_REGN: C29.1, R34.1, U4.22 (REGN)
/CHG_SW: C30.2, L2.1, U4.19 (SW), U4.20 (SW)
/DAC_L: R10.1, U2.6 (OUTL)
/DAC_L_ATT: C17.1, R12.2, R14.1
/DAC_L_FILT: C15.1, R10.2, R12.1
/DAC_R: R11.1, U2.7 (OUTR)
/DAC_R_ATT: C18.1, R13.2, R15.1
/DAC_R_FILT: C16.1, R11.2, R13.1
/GND: B1.3 (GND), C1.2, C2.2, C3.2, C4.2, C5.2, C6.2, C11.2, C12.2, C13.2, C14.2, C15.2, C16.2, C20.2, C21.2, C22.2, C23.2, C24.2, C25.2, C26.2, C27.2, C28.2, C29.2, C31.2, C33.2, C34.2, C35.2, C36.2, H1.1, H2.1, H3.1, H4.1, J1.6 (PIN6), J1.9 (PIN9), J1.14 (PIN14), J1.20 (PIN20), J1.25 (PIN25), J1.30 (PIN30), J1.34 (PIN34), J1.39 (PIN39), J2.1 (FPC1), J2.8 (FPC8), J4.A12 (GND_A), J4.B12 (GND_B), J4.SH (SHIELD), Q1.2 (S), R1.2, R2.2, R14.2, R15.2, R20.2, R32.2, R33.2, R35.2, R37.2, R42.2, SW1.2, SW2.3 (OFF_GND), SW10.2, SW11.2, SW12.2, SW13.2, SW14.2, SW15.2, SW16.2, SW17.2, SW18.2, SW19.2, SW20.2, SW21.2, TP1.1, U2.3 (CPGND), U2.9 (AGND), U2.10 (DEMP), U2.11 (FLT), U2.12 (SCK), U2.16 (FMT), U2.19 (DGND), U3.2 (PGND), U3.11 (GND), U3.15 (PGND), U4.6 (OTG), U4.9 (CE), U4.17 (GND), U4.18 (GND), U4.25 (EP), U5.4 (GND), U6.4 (GND), U7.1 (CTG), U7.4 (GND), U7.6 (QSTRT), U7.9 (EP)
/I2C_SCL: J1.5 (PIN5), TP13.1, U7.7 (SCL)
/I2C_SDA: J1.3 (PIN3), TP12.1, U7.8 (SDA)
/I2S_BCK: J1.12 (PIN12), U2.13 (BCK)
/I2S_DIN: J1.40 (PIN40), U2.14 (DIN)
/I2S_LRCK: J1.35 (PIN35), U2.15 (LRCK)
/LCD_CS: J1.24 (PIN24), J2.5 (FPC5)
/LCD_DC: J1.18 (PIN18), J2.4 (FPC4)
/LCD_LEDA: J2.10 (FPC10), R30.2
/LCD_LED_K: J2.11 (FPC11), J2.12 (FPC12), J2.13 (FPC13), J2.14 (FPC14), Q1.3 (D)
/LCD_RESET: J1.22 (PIN22), J2.2 (FPC2)
/PAM_VREF: C20.1, U3.8 (VREF)
/PBC_ONT: C33.1, U6.3 (ONT)
/PBC_PDT: C34.1, U6.7 (PDT)
/PCM_CAPM: C10.2, U2.4 (CAPM)
/PCM_CAPP: C10.1, U2.2 (CAPP)
/PCM_LDOO: C12.1, U2.18 (LDOO)
/PCM_VNEG: C11.1, U2.5 (VNEG)
/PWR_INT: J1.26 (PIN26), R39.2, TP9.1, U6.5 (INT)
/PWR_KEY: SW1.1, TP8.1, U6.2 (PB)
/PWR_KILL: J1.10 (PIN10), R40.2, TP10.1, U6.8 (KILL)
/SPI_MISO: J1.21 (PIN21), J2.7 (FPC7)
/SPI_MOSI: J1.19 (PIN19), J2.6 (FPC6)
/SPI_SCLK: J1.23 (PIN23), J2.3 (FPC3)
/SPK_L_N: J5.2, U3.3 (-OUT_L)
/SPK_L_P: J5.1, U3.1 (+OUT_L)
/SPK_R_N: J6.2, U3.14 (-OUT_R)
/SPK_R_P: J6.1, U3.16 (+OUT_R)
/SYS: C28.1, C31.1, C35.1, L1.2, L2.2, R38.1, TP3.1, U4.15 (SYS), U4.16 (SYS), U5.3 (VIN), U6.1 (VIN)
/USB_CC1: J4.A5 (CC1), R1.1
/USB_CC2: J4.B5 (CC2), R2.1
/USB_VBUS: C1.1, J4.A9 (VBUS_A), J4.B9 (VBUS_B), TP6.1, U4.1 (VAC), U4.24 (VBUS)

Notes on the sheet:
MARATHON MAIN BOARD SCHEMATIC - NOT YET FABRICATION READY
Validated architecture from breadboard; bare-IC support circuits added from manufacturer references.
VERIFY BEFORE PCB: exact LCD FPC pitch/pinout, membrane geometry, switch footprints, IP5306 exposed-pad land pattern.
PCM5102A is powered from Pi 3.3V (AVDD/CPVDD/DVDD), NOT 5V. SCK/FMT/FLT/DEMP low; XSMT high.
PAM8403 sourced from Slkor (LCSC C5122557). The Diodes Inc. original is NRND/EOL.
IP5306 SW-to-BAT 1uH power loop and all local capacitors must be physically tight in PCB layout.
LCD backlight draft: 5V_SYS -> 22R/0.5W -> LEDA, based on matching 3.2in 18-pin panel (3.1V typ, 90mA typ). Verify actual purchased panel before fab.
Mute: SW2 drives PAM8403 SHDN/MUTE; the amp stays on 5V_SYS so the DAC never drives an unpowered amp. R12-R15 cut full scale by 25.3 dB: about 2.4 V peak at the speaker with 24 dB amp gain, 0.35 W sine or 0.70 W square wave into 8 ohm.
TEST POINTS AND CASE HOLES

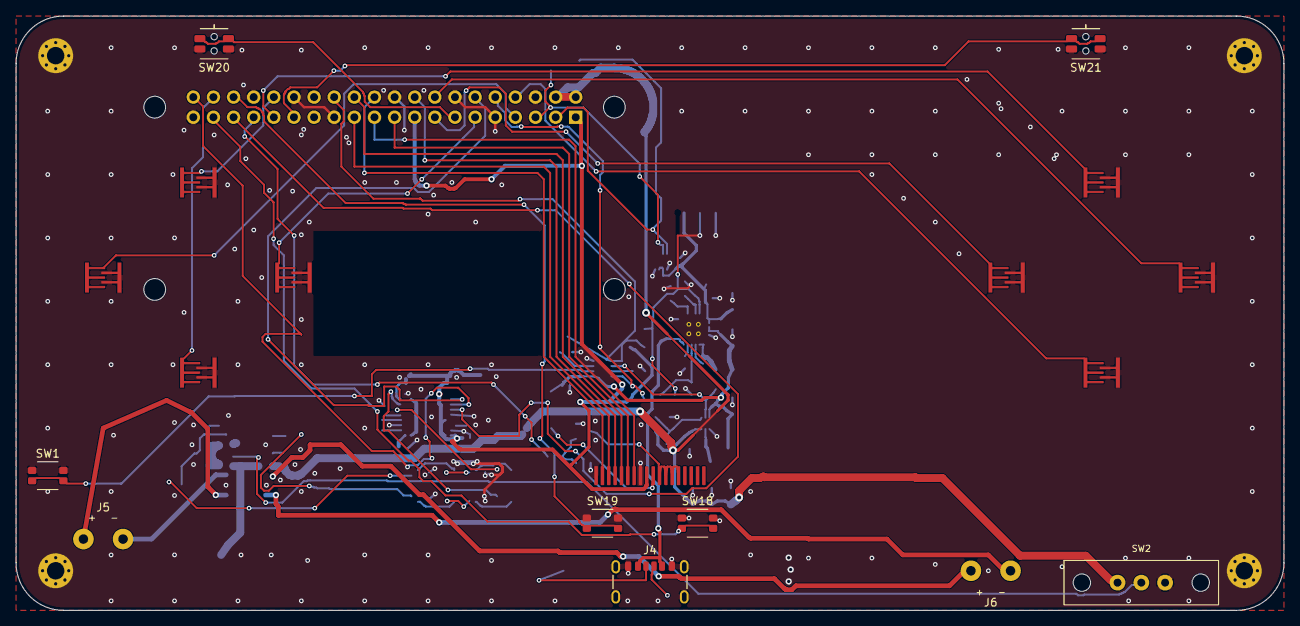
[picture p20: board marathon.kicad_pcb from above]

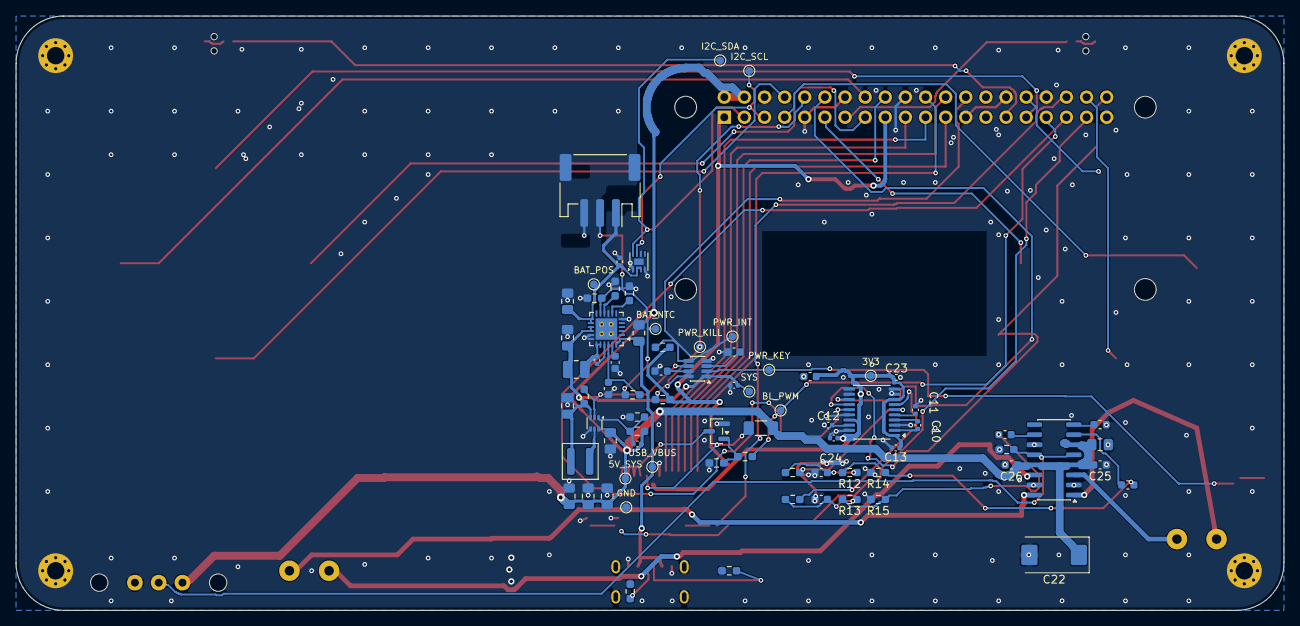
[picture p21: board marathon.kicad_pcb from below]

Board: 2 copper layers, 160.0 x 75.0 mm, 100 parts (78 on the bottom side), 68 nets.

Other parts of the board:
BT1: Battery_LiPo_105063_StandIn
