spudger/marathon/(commit log)

2026-10-23 docs: drop the all-SMT claim from the README
    - Call the board a bare-chip build instead of all-SMT: the Pi Zero 2 W
    solders to the board through its 40-pin header holes, so not every
    part is surface-mount
    - Replace the README's em and en dashes with colons, commas and "to"
2026-10-30 feat: add the KiCad 10 project for the main board
    - Add the schematic, PCB layout and project file under pcb/
    - Add the project-local symbol and footprint libraries, registered through
    sym-lib-table and fp-lib-table with project-relative paths
    - ERC: 0 violations. DRC: 0 errors, 12 library-mismatch warnings,
    48 unrouted connections (LCD, buttons, power key), 0 parity issues
    [marathon.kicad_pcb, marathon.kicad_sch]
2026-10-30 docs: update status and hardware details for the KiCad project
    - README: Phase 3 mostly complete, Phase 4 in progress and not ready for
    fabrication; correct the board size, Pi mounting, buttons and the
    backlight supply in the diagram
    - pcb/README: what the project contains, what is routed, check results and
    the kicad-cli commands to re-run them
    - schematics/README: point to the schematic source in pcb/
    - bom: locked part numbers, support-part values from the schematic, and
    decision log entries for the parts, backlight, layout and Pi mounting
    - PIN_MAPPING: backlight on 5V through R30, PCM5102A on 3.3V, side-push
    shoulder switches
    - PROJECT_PLAN: Phase 3 and 4 checklists, next steps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
2026-10-30 docs: fix Phase 1 status and the power key wiring note
    - README: Phase 1 is mostly complete, matching PROJECT_PLAN
    - bom: scope the direct-GPIO note to gameplay buttons; the power key
    connects to the IP5306 KEY pin
2026-10-30 chore: drop the company and comment fields from the schematic title block
    - Remove the placeholder company name and the two descriptive comments;
    the title, date and revision stay
    [marathon.kicad_sch]
2026-10-31 feat: add the verify-marathon skill
    - Add a helper with launch, doctor, drive, evidence and cleanup steps that
    check the KiCad project in the KiCad Flatpak with no network, no home
    folder and a throwaway config
    - Drive ERC, DRC with schematic parity, a BOM export and schematic, board
    and 3D renders, each on the working tree and on main
    - Keep each run's reports and images in ~/.local/state/verify-marathon/
    - Refuse a project whose library, model or sheet paths leave the project
    or KiCad's own libraries
    - Add unit tests for the helper and a feature map for the four proofs
    - Link the skill for Codex under .agents/skills/
2026-10-31 fix: seal the verify-marathon sandbox and keep failure diagnostics
    - Run KiCad with flatpak --sandbox, which drops the home, /media and
    /run/media grants and KiCad's own data folder, and pass flatpak only
    PATH, HOME, XDG_RUNTIME_DIR and LANG from the host
    - Doctor now also checks media, app data and the sandbox environment
    - Scan hierarchical sheet files and reject paths that climb out of the
    project
    - Fail launch when origin/main has no baseline project instead of
    skipping the comparison
    - Record run ownership before copying, so an early failure cleans up
    - Save command records and partial output when a drive fails
2026-10-31 fix: join the conductive pad fingers to their spines
    - Each finger of Conductive_Pad_5mm_GameBoyStyle ended exactly where its
    spine began, so KiCad treated the pieces as unconnected and reported 24
    unrouted connections inside the D-pad and ABXY pads.
    - Widen each finger to 2.15 mm and shift it 0.05 mm toward its spine, giving
    0.1 mm of overlap. The finger tips and the 0.30 mm spacing between nets
    are unchanged.
    - Apply the same change to SW10 to SW17 on the board so they still match
    the library.
    [marathon.kicad_pcb]
2026-10-31 feat: place the Pi on its guide and finish routing the main board
    - Rotate J1 (Raspberry Pi Zero 2 W) from 90 to 270 degrees about its
    existing anchor. The body now sits exactly on the 65 x 30 mm back-side
    guide (x 34 to 99, y 28 to 58), inside the outline and clear of the
    battery envelope. Pads still match documentation/PIN_MAPPING.md.
    - Reroute J1's 5V, 3V3 and I2S connections for the new position. The DAC
    stubs and vias from main are kept.
    - Route the LCD SPI and control nets as one front-side bundle into the FPC
    tail, with ground vias beside FPC pads 1 and 8 and the backlight anode
    and cathodes taken to R30 and R31 on the back.
    - Route the twelve button nets and the IP5306 po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
    [marathon.kicad_pcb]
2026-10-31 docs: update Phase 4 status for placement and routing
    - README.md: placement and routing are done and DRC reports 0 errors. The
    board is still not ready for fabrication.
    - pcb/README.md: every part placed and every net routed; 0 unrouted
    connections.
    - documentation/PROJECT_PLAN.md: tick placement, routing and DRC, and mark
    the Pi placement and routing next steps done.
2026-10-31 fix: keep signal copper 3 mm clear of the Pi mounting holes
    - An M2.5 screw head or standoff at J1's mounting holes could bridge exposed
    copper: the 5V route passed 2.0 mm from the hole at (95.5, 31.5), and
    routes came 1.9 to 2.2 mm from the other three holes.
    - Route 5V over and down the right of the top hole, and move the LCD
    bundle and the 3V3 lane 1 mm west of the lower hole.
    - Keep every routed track and via, ground stitching included, at least
    3 mm (copper edge to hole centre) from all four holes. Closest is now 3.05
    mm.
    - Leave room beside J1 pin 39 for its thermal spokes.
    [marathon.kicad_pcb]
2026-10-31 fix: redraw the Alps switch and IP5306 footprints
    - SKTHACE010 and SKSCLDE010: four lands from Alps' land pattern drawings. Each switch joins terminals 1-2 and 3-4 inside, so pads 1 and 2 now each sit on one horizontal pair. The old one-pad-per-side pattern bridged both pairs and held every switch closed.
    - SKSCLDE010: add the two 0.8 mm locating holes for the switch bosses.
    - IP5306: four 0.3 mm thermal vias in the exposed pad, connected solid to the ground pour.
2026-10-31 fix: mute the amp through SHDN and limit the audio level
    - SW2 now switches the PAM8403 SHDN/MUTE pins between 5V and GND. The amp stays on 5V_SYS, so the DAC never drives an unpowered amp and C22 is no longer hot-plugged onto the 5V rail.
    - R20 becomes a 100k pull-down that holds the amp off while SW2 moves.
    - Add R12-R15 (8.2k / 680R), a 22.3 dB attenuator per channel, so full scale gives about 0.8 W into 8 ohm with the amp's 24 dB gain.
    - Add local bypass capacitors: C23/C24 at the PCM5102A AVDD and DVDD pins, C25/C26 at the PAM8403 PVDD pins.
    - L1: 1 uH with at least 6 A saturation in a 4 x 4 mm molded footprint. Peak current is about 5.2 A at a 3.0 V battery and 2.1 A out.
    - Move the PC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
    [marathon.kicad_sch]
2026-10-31 fix: rework the power and audio layout for issue #9
    - Move B1, the SW2 terminals, the J6 speaker pads and L1 out of the battery envelope.
    - Pack the IP5306, inductor, battery capacitor and output capacitors into a tight power section with the capacitor grounds facing the exposed pad.
    - Place every PCM5102A and PAM8403 bypass and charge-pump capacitor within 3 mm of its pin.
    - Give each small ground pad in the power and audio areas its own via to the ground plane, and stitch the two ground pours together.
    - Reroute the affected nets. DRC reports 0 errors, 0 unconnected items and 0 parity issues.
    [marathon.kicad_pcb]
2026-10-31 docs: describe the mute circuit, attenuator and open review items
    - README, PIN_MAPPING and PROJECT_PLAN: the mute switch drives the amp's shutdown pins instead of cutting its power.
    - bom/README: new attenuator and bypass parts, R20 at 100k, and the L1 rating.
    - pcb/README: 9 library-mismatch warnings, and the Alps footprints follow Alps' land patterns.
    - PROJECT_PLAN: mark the review fixes done, add the power design step, reopen the LCD pinout, and list the open review items.
2026-10-31 fix: cap full-scale speaker peak at 2.4 V
    - R14/R15 go from 680 to 470 ohm, so the attenuator cuts 25.3 dB.
    - At DAC full scale and the amp's nominal 24 dB gain, the speaker peak is about 2.36 V: 0.35 W for a sine and 0.70 W for a square wave into 8 ohm. The old values allowed 3.31 V, about 1.37 W for a square wave.
    - Correct the README, BOM and schematic notes, which claimed the 680 ohm values kept full scale within the 1 W rating.
    [marathon.kicad_pcb, marathon.kicad_sch]
2026-11-02 docs: state the thin, long-battery goal in the project plan
    - Add the pocketable size and battery life goal to the Context section
    - Note that thinness and battery capacity win over other layout choices
2026-11-02 docs: add the power design spec for issue #11
    - Replace the IP5306 with a BQ25616 charger and a TPS61023 boost
    - Add an LTC2954 power key controller for clean shutdown and forced off
    - Add a MAX17048 fuel gauge and a PWM backlight switch
    - Set the cell requirements, pin assignments and Pi settings
    - List the finish condition, known limits and the open battery size question
2026-11-02 docs: fix the power spec's review findings
    - Size the power key timers for worst-case tolerance: forced off at 5.1 to 10.5 s
    - Add the backlight service that sets the PWM period, duty and shutdown state
    - Keep the battery space decision with the owner
    - Check the charge and input resistors by value and tolerance
    - Add bench checks for temperature cutoffs, low battery shutdown, brightness and load steps
    - Require the TPS61023 feedforward capacitor for the large output capacitance
2026-11-02 docs: correct the power key timer math and NTC test points
    - Take the fixed 1 ms out of the LTC2954 timer equation: 5.33 to 8.33 s per µF
    - Raise PDT to 1.5 µF so forced off needs at least 6.8 s, and allow clean presses up to 6 s
    - Update the turn-on range to 0.7 to 1.5 s and the bench holds to match
    - Move the NTC bench points to 33 kΩ, 10 kΩ and 4.3 kΩ, outside the threshold tolerance
2026-11-02 docs: approve the power spec and grow the battery space
    - Mark the spec approved
    - Record the owner's decision to grow the battery space to 63 x 50 mm
    - Add the larger space to the hardware PR scope and finish condition
    - Drop the resolved open question
2026-11-02 feat: replace the IP5306 power section in the schematic
    - Remove the IP5306 and R31; add BQ25616, TPS61023, LTC2954-1, MAX17048 and AO3400A symbols
    - Charger: RICHG 750R and RILIM 340R at 1%, TS divider 5.23k/30.9k, VSET, D+ and D- open
    - Boost: 750k/100k feedback for 5.06 V, 220 pF feedforward, 1M EN pull-up to SYS
    - Power key: ONT 0.15 uF and PDT 1.5 uF, INT on GPIO7 and KILL on GPIO15 with 10k pull-ups
    - Fuel gauge on the cell with SDA on GPIO2 and SCL on GPIO3
    - Backlight MOSFET on LCD_LED_K driven from GPIO13 through 100R with a 100k pull-down
    - Battery connector becomes the 3-pin JST PH with the NTC; C22 becomes a 220 uF polymer
    [marathon.kicad_sch]
2026-11-02 feat: lay out the new power section and grow the battery space
    - Place the BQ25616 charger, TPS61023 boost, LTC2954 power key controller, MAX17048 gauge and backlight MOSFET on the back
    - Move the battery connector to the cell's edge with its opening facing the cell, and grow the battery envelope to 63 x 50 mm
    - Route the new nets with neck-downs at the 0.5 mm pitch pins; reroute the backlight anode, right speaker and select button lines the new parts landed on
    - Use a project copy of the RTW footprint with four 0.3 mm vias in the exposed pad, matching the board's minimum drill
    - Add a design rule allowing 0.12 mm inside the SOT-563 and TSOT-23-8 courtyards, whose stock land patterns sit 0.1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
    [marathon.kicad_pcb, marathon.kicad_sch]
2026-11-02 docs: describe the new power section and the 63 x 50 mm battery space
    - README, project plan and pin mapping: the charger, boost, power key controller and fuel gauge replace the IP5306, and GPIO2/3/7/13/15 are assigned
    - BOM notes: new parts with LCSC numbers, cell requirements, 3-pin battery connector pin order, low-profile C22, and a decision log entry
    - PCB README: the fine-pitch design rule, the project RTW footprint and the new DRC count
    - Spec 011: 0.1 uF gauge bypass and 5.06 V boost output, as built, and the height check scoped to the new power parts
2026-11-02 fix: enable the mask, paste and Fab layers on the main board
    - Add F.Mask, B.Mask, F.Paste, B.Paste, F.Fab and B.Fab to the board's
    layer table. Pads already used the mask and paste layers, and the Fab
    outlines already existed, but the layers were off, so Gerber exports
    had no soldermask or paste files and the 3D view showed bare copper.
    - Record the 82 DRC warnings the Fab layers bring in: reference, value
    and note text on B.Fab that is not mirrored. Fab layers are not sent
    for fabrication.
    [marathon.kicad_pcb]
2026-11-02 fix: put the PMID and boost output capacitors beside their pins
    - C27 becomes a 0603 10 uF 10 V part directly under the BQ25616 PMID pin, 1.6 mm of trace, with a ground via 0.9 mm from its ground pad
    - VBUS reaches the charger from the side so the PMID pin can drop straight to C27; REGN runs straight down to C29
    - Tie the charger's paired BAT, SYS and SW pins pad to pad
    - Move C6 beside the TPS61023 VOUT pin, 1.6 mm of trace, and add a ground via at the boost's ground pin
    - Shift the feedback divider, R34 and R38 to make room
    [marathon.kicad_pcb, marathon.kicad_sch]
2026-11-02 docs: mark the VCELL 505060 as an unconfirmed fit
    - Its listed maximum is 50.5 x 62.5 mm; the space is 63 x 50 mm, so the length fits but the width needs a supplier drawing
    - BOM notes record C27 as a 0603 10 V part
2026-11-05 feat: add test points and M2 case holes to the schematic
    - Add TESTPOINT and MOUNTINGHOLE symbols to the project library.
    - Add TP1 to TP13 on GND, BAT_POS, SYS, 5V_SYS, 3V3, USB_VBUS, BAT_NTC,
    PWR_KEY, PWR_INT, PWR_KILL, BL_PWM, I2C_SDA and I2C_SCL, each valued with
    its net name so the board silkscreen shows it.
    - Add H1 to H4, plated M2 case holes tied to GND.
    [marathon.kicad_sch]
2026-11-05 feat: add case holes and a Pi antenna keep-out to the board
    - Place H1 to H4, plated M2 holes tied to GND, centered 5 mm in from each
    edge, and drop the B.Fab M3 placeholder circles and the GND vias in their way.
    - Add a PI_ANTENNA_KEEPOUT rule area on F.Cu and B.Cu over x 56.6 to 86,
    y 47 to 63: the Pi Zero 2 W antenna, between its mini-HDMI and USB data
    ports on the edge opposite the GPIO header, plus 5 mm.
    - Reroute 3V3, BL_PWM, BTN_SELECT, BTN_START, I2S_BCK, I2S_DIN, I2S_LRCK
    and PWR_INT around it and remove the GND stitching vias inside it.
    - Join the GND pour pieces the reroute cut off with two stitching vias and
    a short GND link near J2.
    - Draw both GND pours over the whole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
    [marathon.kicad_pcb]
2026-11-05 feat: add 13 labeled test pads on the back of the board
    - Place TP1 to TP13, 1.0 mm pads on B.Cu, outside the Pi, battery and
    antenna areas so a probe reaches each one with the board assembled.
    - Each pad sits on its net's track or via where there is room, otherwise
    on a short back-side stub. PWR_KILL uses a via in the pad down to its
    front-side track, and I2C_SCL a short routed link, because a 5V_SYS track
    and the BTN_B and BTN_Y tracks fence them in on the back.
    - Print each net name beside its pad on B.SilkS and keep the reference on B.Fab.
    - Add a GND stitching via where the pads cut a pour piece off.
    [marathon.kicad_pcb]
2026-11-05 fix: clear five footprint library mismatch warnings
    - C1, C2, C6 and J6: turn the pads and texts the 180 degrees back to the
    library orientation. The pads are symmetric, so the copper is unchanged.
    - J1: save the board's Pi footprint to the project library, flipped to the
    front side. The board copy keeps its checked pin order: seen from the back,
    pin 1 sits at the SD card end and pin 2 toward the board edge.
    [marathon.kicad_pcb]
2026-11-05 docs: describe the holes, test pads, antenna keep-out and U2/U3 defect
    - pcb/README.md: list the case holes, test pads and antenna keep-out, update
    the DRC row, and record the mirrored U2 and U3 footprints as a known defect.
    - PROJECT_PLAN.md: tick test points, the keep-out and the case holes, and add
    the U2 and U3 fix and silkscreen artwork as open items.
    - README.md: drop test points from Phase 3's open work and note the U2 and
    U3 defect in Phase 4.
2026-11-05 fix: keep pads out of the antenna area and test pads off the microSD
    - Make PI_ANTENNA_KEEPOUT disallow pads and start it at x 57.4, so SW13's
    GND contact, the D-pad's right contact, stays outside. The margin is
    4.2 mm on that side and 5 mm elsewhere.
    - Move TP12 (I2C_SDA) and TP13 (I2C_SCL) to the strip above the Pi's header
    edge. They sat under the microSD card's overhang and TP13's label ran
    under the Pi. Route both with short links and drop their old stubs.
    - Update pcb/README.md to match.
    [marathon.kicad_pcb]
2026-11-06 fix: mirror U2 and U3 on the back side and reroute them
    - Replace U2 (PCM5102A, TSSOP-20) and U3 (PAM8403, SOIC-16) with their
    stock footprints flipped to the back. Their pads used front-side
    positions, so each chip's pin order was mirrored.
    - Reflect each chip's capacitor cluster (C10, C11, C12; C18, C20, C21,
    C25, C26, R20) with it, so the charge pump, VNEG, LDOO and supply
    decoupling loops keep their original lengths.
    - Reroute the nets cut at the cluster edges: 3 more vias and 31 mm more
    track across the 25 nets touched, with both ground pours connected.
    [marathon.kicad_pcb]
2026-11-06 docs: record the U2 and U3 footprint fix
    - Drop the known-defect note from pcb/README.md and the README, and
    record DRC at 0 errors and 0 warnings.
    - Check off the footprint fix in the project plan and remove it from
    the open design review items.
2026-11-06 fix: put C23 back at U2's AVDD pin and restore pad pin names
    - Swap C13 and C23 so C23, the AVDD bypass, sits at pin 8 after the
    mirror. Both are 0.1 uF from 3V3 to GND, so the copper is unchanged.
    - Restore the pin function and type on U2's and U3's pads, which the
    footprint swap left empty.
    [marathon.kicad_pcb]
2026-11-07 fix: move C24 to U2's DVDD pin and widen the amp's 5V feed
    - Move C24, the DVDD bypass, beside U2 pin 20, 1.5 mm from it, with a
    direct trace. The mirror had left it about 7 mm away.
    - Restore the 5V_SYS feed to U3 to the PWR_5V width of 1.0 mm; five
    segments, about 23 mm, had been narrowed to 0.8 mm.
    - Nudge an I2S_DIN via 0.1 mm to keep 0.25 mm from the wider trunk.
    [marathon.kicad_pcb]
2026-11-07 docs: say where U2's bypass capacitors sit
    - Reword the pcb/README.md line so it covers every capacitor at U2 and
    U3, not only the reflected ones.
2026-11-07 docs: start the spec for a 4000 mAh battery space
    - Add planning/specs/022-BATTERY-SPACE.md with the measured free area
    on the back of the board, the cell requirements, runtime estimates
    and the references to the current 63 x 50 mm space
2026-11-07 docs: record the cell search and the Pi stack depth
    - Estimate the rear Pi stack at about 9.8 mm and cap the cell at about
    9 mm to leave room for swelling
    - Add realistic capacity by size class, the in-stock candidates with
    their sources, the near misses and the checks for an arriving cell
    - Extend the runtime table to 3000 and 3500 mAh
2026-11-07 docs: take the 105060 class at about 1 mm more depth
    - Record the owner's choice of a 10 mm, 105060-class cell over staying
    at the Pi's depth, and update the goal, size requirement and open
    questions to match
2026-11-07 docs: record the 105060 search and the Pi's height from online sources
    - Replace the single forum figure with four online height sources and
    a 10.0 mm stack estimate (9.7 to 10.4 mm)
    - Add the 105060-class candidates, the add-on NTC part and the
    recommended cell with its unconfirmed points
2026-11-07 docs: add the hand-off changes and finish condition to the battery spec
    - List the board, spec 011, docs and case changes for one build PR
    - Add its finish condition: DRC, a clear outline, and no stale size
    or capacity left outside planning
    - Extend What else uses this with the capacity and thickness hits
2026-11-07 docs: tidy the battery spec after a full read
    - Put the recommended cell after the near misses
    - Add stock status to the recommended cell's unconfirmed points
    - Fix the side clearance wording and line wrapping
2026-11-07 docs: address the first review of the battery spec
    - Turn B1 to open toward the top edge, since its plug and wires would
    press into a full-length cell
    - Budget the installed stack (cell tolerance, adhesive, swelling) at
    about 11.3 mm, 1.3 mm over the Pi
    - Mark the recommended cell provisional, and the 3500 mAh fallback as
    a runtime compromise
    - Require separate charge and discharge ratings, and an ice-water
    check that tells a B3435 NTC from a B3950 one
    - Widen the stale-reference search and list B1's references
2026-11-07 docs: place the turned B1 clear of the battery outline
    - Move B1's center to about x = 106.3 so its turned courtyard stays
    out of the cell outline
2026-11-07 feat: grow the battery outline and turn B1 toward the top edge
    - Move the B.Fab battery outline to (112, 28) to (179, 87) and relabel
    it for a 105060-class cell, at most 57 x 65 x 10 mm with its PCM
    - Turn B1 to open toward -y at (106.3, 42), so its plug and wires sit
    in the empty column above it instead of against the cell
    - Reroute B1's BAT_POS, BAT_NTC and GND pads, and jog the I2C_SDA
    test-pad branch around B1's left mounting pad
    [marathon.kicad_pcb]
2026-11-07 docs: describe the 4000 mAh battery space
    - Approve spec 022
    - Replace the 63 x 50 x 6 mm space and 2000 to 3000 mAh target with
    the 67 x 59 mm space and a 4000 mAh, 105060-class cell in the README,
    BOM, pin map and project plan
    - Name the provisional cell, its fallback and the add-on NTC in the BOM,
    and add a dated decision row
    - Point spec 011's decision 6 and size row to spec 022
    - Note the case's 11.3 mm clearance over the battery in Phase 5
2026-11-07 docs: describe the cell thickness as nominal, apart from the case clearance
    - Battery label and project plan give 57 x 65 mm as the limit and about
    10 mm as the nominal thickness
    - Project plan separates the 10 mm cell from the 11.3 mm installed
    clearance over it
    [marathon.kicad_pcb]
2026-11-07 docs: note the battery plug fit check
    - Battery connector row: B1 now opens toward the top edge, and the mated
    plug and its wire bend need a fit check when the cell arrives
2026-11-08 feat: add stand-in 3D models for the project footprints
    - Add tools/render/models.py, which builds STEP models with CadQuery for the Pi Zero 2 W, the LCD, the Alps switches, the slide switch, and the battery
    - Take outlines from the footprints and specs and the Pi's port positions from its mechanical drawing; mark every estimate in the docstrings
    - Write colors in sRGB, so KiCad shows them as chosen
    - Add tests that read each model back from its STEP file
2026-11-08 feat: give the board a black mask and link the stand-in models
    - Define the stackup: black mask on both sides, white silkscreen, ENIG finish, and 1.0 mm in total
    - Link each project footprint, on the board and in the library, to its stand-in model
    - Add BT1, a board-only battery stand-in with no pads, kept out of the BOM and the placement file
    - Add tests for the stackup, the model links, and BT1
    [marathon.kicad_pcb]
2026-11-08 feat: add the board render script and the first renders
    - Add tools/render/render.py, which runs kicad-cli in a sandbox and writes four fixed views to pcb/renders/
    - Add tests for its views, for a failed kicad-cli run, and for a view that writes no image
    - Commit the top, bottom, and two angled renders
    [render.py, test_render.py]
2026-11-08 docs: describe the renders and the stand-in models
    - Add tools/render/README.md with the commands, what the models are, and their limits
    - Show the angled renders in pcb/README.md and note the stackup
    - Add tools/render/ to the README's repository layout
2026-11-08 fix: give the slide switch stand-in its 5 mm actuator
    - Raise the SS12F15-G5 actuator from 3 mm to 5 mm above the body, as G5 means
    - Add a test for the actuator's height
    - Rebuild that model and the renders
    [models.py]
2026-11-08 fix: make the solder mask render black, not brown
    - Replace KiCad's translucent "Black" mask preset with #0A0A0AF2, a near-black at 95% opacity, on both sides; the preset let the tan core show through
    - Test that both masks are near-black and at least 94% opaque
    - Rerender the four views
    [marathon.kicad_pcb]
2026-11-08 docs: record the LCD and Pi header clearance risk
    - Add the risk that the LCD sits over the Pi header's front pin ends, with trimming and taping the pins as the default fix
2026-11-08 docs: open the README with the board render
    - Show the angled front render at the top of README.md
    - Update the hero render draft: the case render and the social preview remain
2026-11-08 docs: move the hero render draft into the case concept spec
    - Rename only, so git log --follow traces the idea from the draft to spec 027.
2026-11-08 docs: write the first case concept spec
    - Record the ask-round decisions for the 3D-printed case (#27).
    - Choose the geometry source, the KiCad render path, and the inside lens pocket, with the
    approaches weighed and the render prototype's results.
    - Lay out the stack, shells, fasteners, front, edges, back, printing, and hardware, with the
    provisional figures and what replaces each.
    - Name the renders, files, risks, changes, finish condition, and what else uses this.
2026-11-08 docs: fix the gasket, D-pad pivot, cap chamfer, and screw bore in spec 027
    - Size the gasket from the measured lens-to-glass gap, so a panel sitting low stays firm.
    - Define the D-pad's pivot and center-nub stop, so a pressed arm reaches full dome travel.
    - Put the cap flange's chamfer on the face that points at the bed when printed top down.
    - Give the insert hole and the screw-tip bore their end depths.
    - Require the clearance check to hold through each part's motion, not only at rest.
2026-11-08 docs: settle the cap flanges, D-pad stop, and motion check in spec 027
    - Give every cap flange a flat bearing face and an outer 45° chamfer, and drop the hole chamfer.
    - Correct the D-pad arithmetic: the dome bottoms out before the 0.7 mm center nub lands.
    - Size the Start and Select caps so their flanges stay 1 mm apart.
    - Leave the pressed actuator, plunger, or dome out of the motion check, and sweep the mute
    switch's actuator through its slot.
2026-11-08 docs: approve spec 027
    - The owner approved the case concept spec on 2026-11-08.
2026-11-08 feat: read the case's inputs from the KiCad board
    - case/board.py reads the outline, the four M2 case holes, and each part's position and side
    from pcb/marathon.kicad_pcb, so the case follows the layout.
    - Tests check them against the figures in the project plan and spec 027.
2026-11-08 feat: model the first case concept in CadQuery
    - case/case.py builds the two shells, the caps, the shoulder buttons, and stand-ins for the
    silicone pads, speakers, lens, and gasket from the board's positions (spec 027).
    - It writes the assembly as case/step/marathon-case.step and one STL per printed part, standing
    in its print orientation, in case/stl/.
    - case/board.py exports the board's 3D models through the sandboxed kicad-cli the board renders
    use, for the clearance tests.
    - Tests check against KiCad's STEP export: no overlaps at rest or through each part's motion,
    spec 022's battery space, each cap's reach, the 164.2 x 79.2 x 20.4 mm body, the screw path,
    and the STLs.
    - ABXY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
    [back-shell.stl, cap-abxy.stl, cap-dpad.stl, cap-power.stl, cap-start-select.stl, front-shell.stl, marathon-case.step, shoulder.stl]
2026-11-08 feat: render the board in its case
    - case/render.py renders the assembled case from the front and back, an exploded view, and a
    1280 x 640 social preview through kicad-cli, on a scratch copy of pcb/ with a board-only
    footprint that carries the case's models; pcb/ is never written.
    - It cuts KiCad's STEP export of the board and the case at y = 53 mm and draws the section,
    with the stack's levels labeled.
    - board.py loads tools/render/render.py under its own module name, since case/render.py shares
    the name.
    - The lens model is dark and mostly transparent, so the screen reads black.
2026-11-08 chore: rebuild the case outputs from the final code
    - The lens's render color changed the STEP assembly; the renders are redrawn to match.
    [marathon-case.step]
2026-11-08 docs: document the case concept and make the README lead with it
    - README.md opens with the case render and lists Phase 5's first concept.
    - case/README.md covers the files, build, renders, tests, printing, hardware, and assembly.
    - PROJECT_PLAN.md and bom/README.md describe the case, its M2 screws and inserts, the lens and
    foam, and CadQuery, and log the decision.
    - Spec 027 records the 9 mm ABXY caps and the right speaker at (150, 80), which the build chose.
2026-11-08 fix: pin Python 3.12 in the CadQuery commands
    - uv now picks Python 3.14 by default, and cadquery-ocp 7.7 has no wheels for it, so the
    commands in tools/render failed as written.
    [models.py]
2026-11-08 test: press the switch caps and shoulders through the gap before contact
    - Each press now closes the 0.2 mm gap spec 027 allows before the switch's 0.25 mm travel,
    so the motion check covers a whole press.
2026-11-08 docs: show the board's front and back renders in the README
    - Add pcb/renders/angle-front.png and angle-back.png side by side, at half width each, at the
    end of the Design section, below the case hero
    - Caption them as the bare board, rendered from the KiCad layout
2026-11-08 feat: sit the LCD stand-in on trimmed header pins
    - Trim the Pi header's pins to 0.3 mm proud of the main board's front in the Pi stand-in,
    the default fix the project plan names for the LCD over the header
    - Lower the LCD stand-in to 0.5 mm off the board, on the trimmed pins and Kapton tape,
    from the 1.5 mm gap assumed for untrimmed pins
    - Test both heights, and probe the panel below its new screen top
    - Rebuild the two changed STEP models
    [models.py]
2026-11-08 feat: slim the case from 20.4 to 18.5 mm
    - Front face from z 7.5 to 6.0: the LCD's glass drops 1.0 mm, a 0.5 mm lens, and the plate's
    inside moves to z 4.5
    - Back face from z -12.9 to -12.5: a 1.2 mm floor; the battery space stays 11.3 mm
    - Pockets in the plate's inside, leaving 0.8 mm of plate, over the cap flanges, the speakers,
    and the mute switch's body
    - Cap flanges 0.7 mm thick with a 0.5 mm chamfer, on the same domes; shoulder buttons 0.5 mm
    shorter to stay under the plate
    - M2 x 12 mm screws seated 4.5 mm deep, tips at z 4.0; insert hole to 4.5, bore to 5.2
    - A 6.0 mm tall USB-C pocket, clear of the front edge's fillet
    - The section drawing takes its levels and depth from case.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
    [case.py, render.py, test_case.py]
2026-11-08 chore: rebuild the case outputs and the board renders at 18.5 mm
    - case/step and case/stl from the slimmed model
    - case/renders: the five views, with the section's levels at 6.0, 4.5, -11.3, and -12.5
    - pcb/renders: the four board views, with the LCD on the trimmed header pins
    [back-shell.stl, cap-abxy.stl, cap-dpad.stl, cap-power.stl, cap-start-select.stl, front-shell.stl, marathon-case.step, shoulder.stl]
2026-11-08 fix: keep the cap flanges' 0.75 mm printing overhang
    - Flanges grow 1.25 mm past the cap body, not 1.5, so the flat bearing face still overhangs
    the body by 0.75 mm above the 0.5 mm chamfer, as spec 027's printing table needs
    - The D-pad's pivot returns to 15.25 mm from its center, at the pocket's ceiling
    - Rebuild the STEP, the STLs, and the case renders
    [cap-abxy.stl, cap-dpad.stl, cap-power.stl, cap-start-select.stl, front-shell.stl, marathon-case.step]
2026-11-08 docs: record the 18.5 mm case and the back-shaping question
    - Spec 027: decisions 13 to 16, the new stack and fasteners, the pockets, the hardware, the
    provisional figures, two new risks, the finish condition, and a "Slimming" section with what
    was cut and what stops it going thinner
    - PROJECT_PLAN: the case row, and the "LCD over the Pi header" risk is now decided
    - bom: M2 x 12 mm screws, the 0.5 mm lens, Kapton tape, and a decision-log row
    - case/README: the size, the checkpoint tag, the hardware, and a first assembly step to trim
    the header pins
    - README and tools/render/README: the size and the LCD's new height
    - planning/drafts/CASE-BACK-SHAPING.md: the ergonomics research the ow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
2026-11-08 fix: keep the USB-C pocket under the front edge's fillet
    - The pocket around the USB-C opening is 4.7 mm tall instead of 6.0, centered on the
    receptacle, so it ends at z 4.98, under the 1.0 mm fillet that starts at z 5.0, and leaves
    no 0.3 mm lip over it
    - Test the pocket and the wall over it
    - Rebuild the STEP, the two shells' STLs, and the case renders
    [back-shell.stl, front-shell.stl, marathon-case.step]
2026-11-08 docs: correct the USB-C pocket and the back-shaping figures
    - Spec 027: the 4.7 mm pocket in "Edges" and "Slimming", and the overmold limit it brings in
    the USB-C risk
    - CASE-BACK-SHAPING.md: spec 022's battery space is x 112 to 179 and y 28 to 87, and the
    stand-in cell x 114 to 177 and y 32.5 to 82.5; the back-edge chamfer estimate drops to about
    2.5 mm at the right end
2026-11-12 docs: record the back-shaping research findings
    - Add the 2026-11-09 findings to the back-shaping draft: the answer, the
    evidence and how strong it is, comparable devices, options for Marathon,
    what is still unknown, and sources
    - Leave the decision open for the owner
